eSpark-Backup/johnwollam-lcdproject/Software-Files/MessageApp/ODES/Resources/tbbg3.jpg

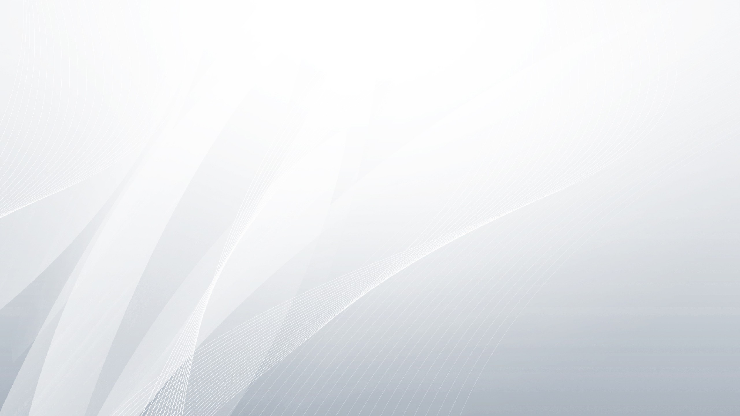
Software-Files/MessageApp/ODES/Resources/tbbg3.jpg
