eSpark-Backup/johnwollam-lcdproject/README.md

# JohnWollam-LCDProject
To develop an LCD based Security System for StorGuard
