eSpark-Backup/johnwollam-lcdproject/Design files/_Design_Files_New/John_Wollam.PcbDoc.htm

Reporting Options

# File in Previous Format

Date | : | 5/25/2022
Time | : | 8:13:49 PM
Filename | : | C:\GitHub\JohnWollam-LCDProject\Design files\_Design_Files_New\John_Wollam.PcbDoc

Version | Warning

This file was generated by an earlier version of the software
