eSpark-Backup/johnwollam-lcdproject/Deliverables/Renderings/2D_Bottom_View.PNG

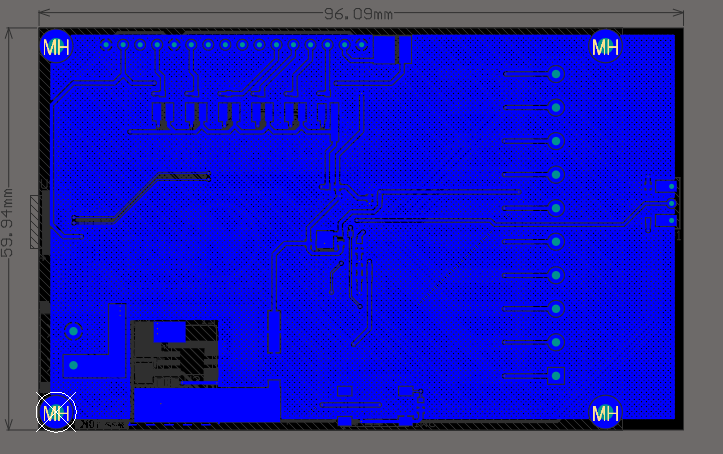
Deliverables/Renderings/2D_Bottom_View.PNG
