eSpark-Backup/johnwollam-lcdproject/Deliverables/Renderings/2D_Top.PNG

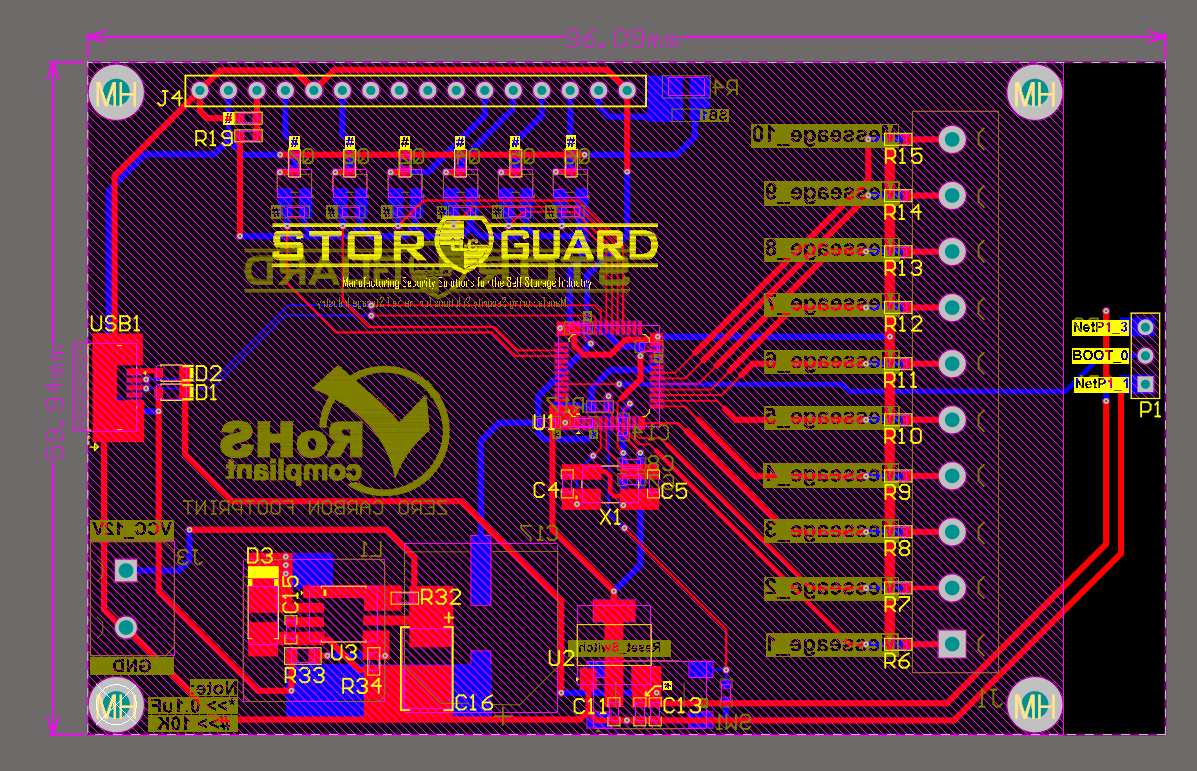
Deliverables/Renderings/2D_Top.PNG
