eSpark-Backup/johnwollam-lcdproject/Deliverables/Renderings/3D_Bottom.PNG.png

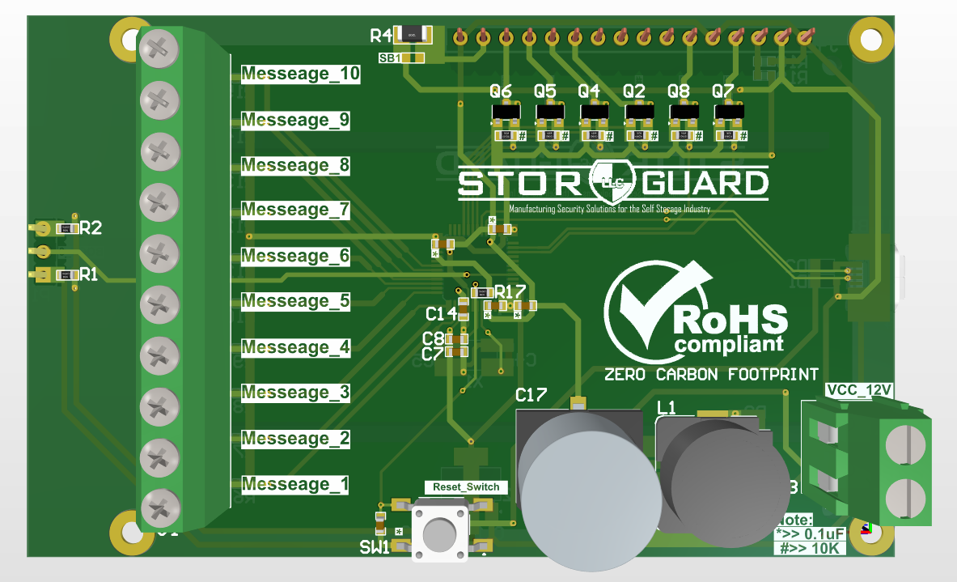
Deliverables/Renderings/3D_Bottom.PNG.png
