eSpark-Backup/johnwollam-lcdproject/Deliverables/Renderings/3D_Isometric.PNG

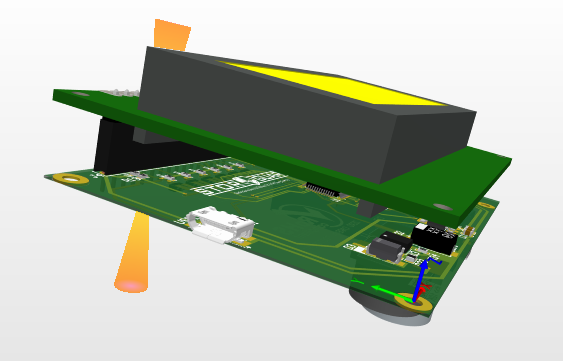
Deliverables/Renderings/3D_Isometric.PNG
