eSpark-Backup/johnwollam-lcdproject/Deliverables/Renderings/3D_Isometric_1.PNG

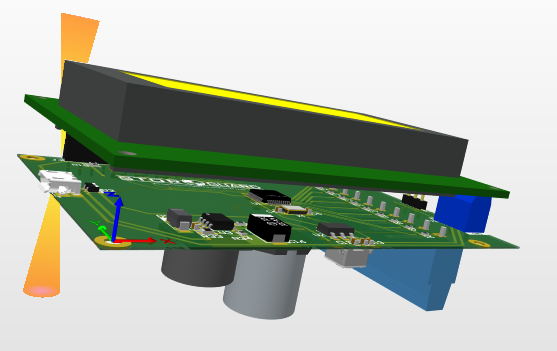
Deliverables/Renderings/3D_Isometric_1.PNG
