eSpark-Backup/johnwollam-lcdproject/Deliverables/Renderings/3D_Isometric_1.PNG.png

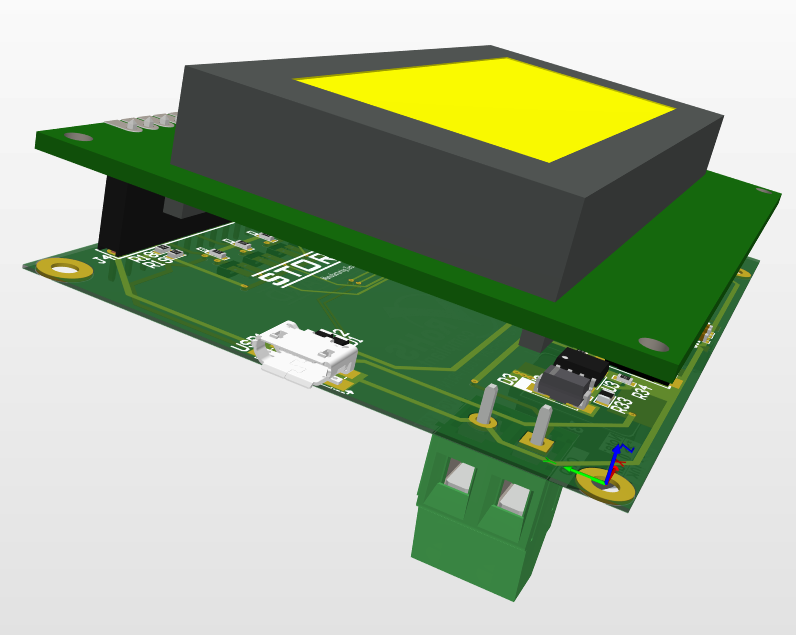
Deliverables/Renderings/3D_Isometric_1.PNG.png
