eSpark-Backup/johnwollam-lcdproject/Deliverables/Renderings/3D_Isometric_View.PNG

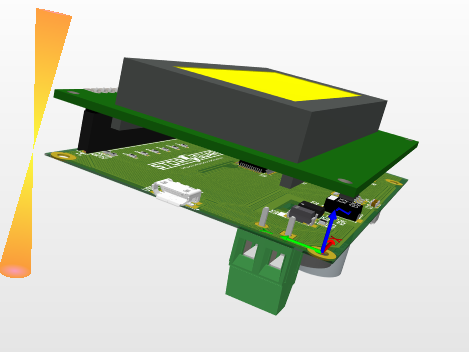
Deliverables/Renderings/3D_Isometric_View.PNG
