eSpark-Backup/johnwollam-lcdproject/Deliverables/Renderings/3D_Top.PNG.png

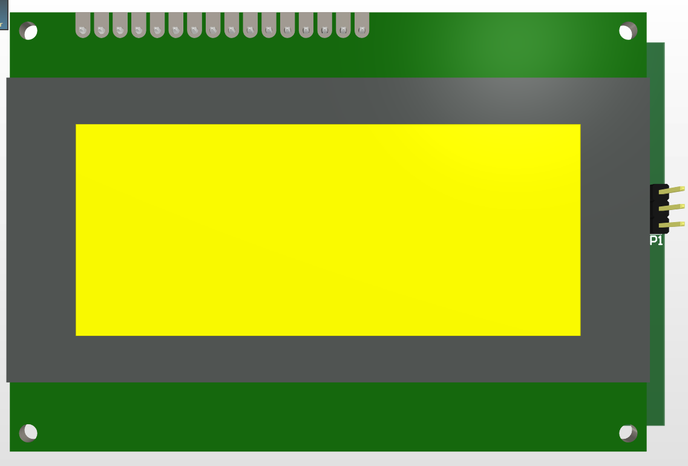
Deliverables/Renderings/3D_Top.PNG.png
