eSpark-Backup/johnwollam-lcdproject/Software-Files/MessageApp/ODES/Resources/bg2.jpg

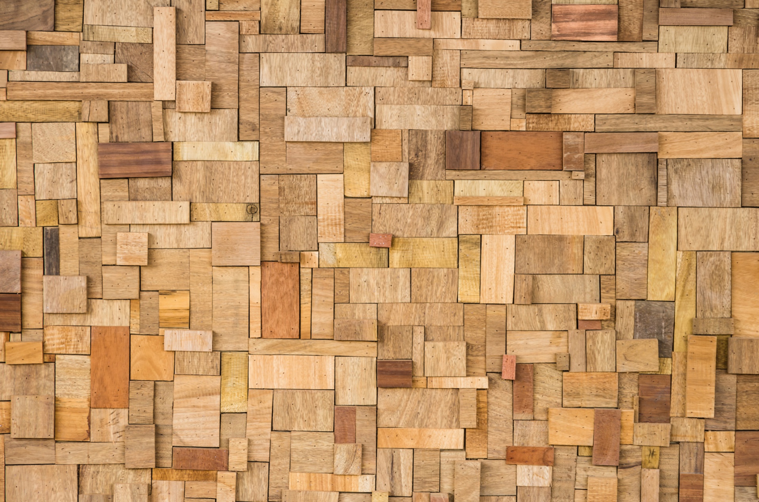
Software-Files/MessageApp/ODES/Resources/bg2.jpg
