eSpark-Backup/johnwollam-lcdproject/Software-Files/MessageApp/ODES/Resources/LoginScreen.png

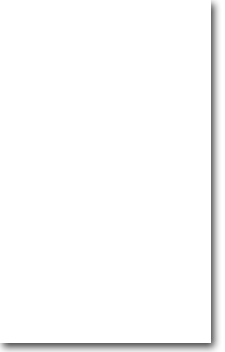
Software-Files/MessageApp/ODES/Resources/LoginScreen.png
