eSpark-Backup/johnwollam-lcdproject/Deliverables/BOM/Espark_BOM.xlsx

 |  | Component list |  | Bill of Materials for Project [John Wollam]
 |  | Source Data From: |  | John Wollam
 |  | Project: |  | John Wollam
 |  | Variant: |  | None
# | Item Type | Designator | Description | Footprint | Manufacturer Part Number | Manufacturer | Alternate Part Number | LCSC/Part Number | Value | Quantity | Quantity (10 Boards) | MOQ (10 Boards) | Quantity (25 Boards) | MOQ (25 Boards) | Links | Unit Cost (10 Boards) | Total Cost (10 Boards) | Unit Cost (25 Boards) | Total Cost (25 Boards) | Remarks | Reviewer Remarks
1 | Capacitor | C1, C2, C3, C6, C9, C10 | CAP CER 0.1UF 50V Y5V 0603 | Cap-0603 | CC0603ZRY5V9BB104 | Yageo | - | C106221 | 0.1uF | 6 | 60 | 100 | 150 | 200 | LCSC (https://lcsc.com/product-detail/Multilayer-Ceramic-Capacitors-MLCC-SMD-SMT_YAGEO-CC0603ZRY5V9BB104_C106221.html) | $0.0029 | $0.29 | $0.0029 | $0.58
2 | Capacitor | C4, C5 | CAP CER 20PF 50V C0G/NPO 0603 | Cap-0603 | CC0603JRNPO9BN200 | Yageo | - | C105621 | 20pF | 2 | 20 | 100 | 50 | 100 | LCSC (https://lcsc.com/product-detail/Multilayer-Ceramic-Capacitors-MLCC-SMD-SMT_YAGEO-CC0603JRNPO9BN200_C105621.html) | $0.0029 | $0.29 | $0.0029 | $0.29
3 | Capacitor | C7, C13 | CAP CER 1UF 50V X7R 0603 | Cap-0603 | UMK107AB7105KA-T | Taiyo Yuden | - | C105174 | 1uF | 2 | 20 | 40 | 50 | 60 | LCSC (https://lcsc.com/product-detail/Multilayer-Ceramic-Capacitors-MLCC-SMD-SMT_Taiyo-Yuden-UMK107AB7105KA-T_C105174.html) | $0.0294 | $1.18 | $0.0294 | $1.76
4 | Capacitor | C8 | CAP CER 10000PF 50V X7R 0603 | Cap0603 | CC0603KRX7R9BB103 | Yageo | - | C100042 | 10000pF | 1 | 10 | 100 | 25 | 100 | LCSC (https://lcsc.com/product-detail/Multilayer-Ceramic-Capacitors-MLCC-SMD-SMT_YAGEO-CC0603KRX7R9BB103_C100042.html) | $0.0022 | $0.22 | $0.0022 | $0.22
5 | Capacitor | C11, C14 | CAP CER 4.7UF 25V X5R 0603 | Cap-0603 | GRM188R61E475KE11D | Murata | - | C90057 | 4.7uF | 2 | 20 | 30 | 50 | 60 | LCSC (https://lcsc.com/product-detail/Multilayer-Ceramic-Capacitors-MLCC-SMD-SMT_Murata-Electronics-GRM188R61E475KE11D_C90057.html) | $0.0677 | $2.03 | $0.0677 | $4.06
6 | Capacitor | C15 | CAP CER 470pF 10% X7R 50V 0603 SMD | Cap-0603 | CC0603KRX7R9BB471 | Yageo | - | C107092 | 470pF | 1 | 10 | 100 | 25 | 100 | LCSC (https://lcsc.com/product-detail/Multilayer-Ceramic-Capacitors-MLCC-SMD-SMT_YAGEO-CC0603KRX7R9BB471_C107092.html) | $0.0026 | $0.26 | $0.0026 | $0.26
7 | Capacitor | C16 | CAP TANT 100UF 20% 25V 2917 | Case-E | TAJE107M025RNJ | Kyocera AVX | - | C7230 | 100uF | 1 | 10 | 12 | 25 | 28 | LCSC (https://lcsc.com/product-detail/Tantalum-Capacitors_Kyocera-AVX-TAJE107M025RNJ_C7230.html) | $1.0548 | $12.66 | $1.0548 | $29.53
8 | Capacitor | C17 | 470uF ±20% 50V 12.5mm 13.5mm 1000hrs 105℃ -40℃~+105℃ SMD,12.5x13.5mm Aluminum Electrolytic Capacitors - SMD RoHS | Custom | VT1H471MI135000CE0 | Changzhou Huawei Elec | - | C191227 | 470uF | 1 | 10 | 12 | 25 | 28 | LCSC (https://lcsc.com/product-detail/Aluminum-Electrolytic-Capacitors-SMD_Changzhou-Huawei-Elec-VT1H471MI135000CE0_C191227.html) | $0.3718 | $4.46 | $0.3453 | $9.67
9 | Diode | D1, D2 | DIODE GEN PURP 75V 150MA SOD323 | SOD-323 | 1N4148WS-7-F | Diodes | - | C60580 | - | 2 | 20 | 40 | 50 | 60 | LCSC (https://lcsc.com/product-detail/Switching-Diode_Diodes-Incorporated-1N4148WS-7-F_C60580.html) | $0.0258 | $1.03 | $0.0258 | $1.55
10 | Diode | D3 | 40V 500mV@2A 2A SMA(DO-214AC) Schottky Barrier Diodes (SBD) ROHS | SMA | SS24A | Guangdong Hottech | - | C2886579 | - | 1 | 10 | 20 | 25 | 40 | LCSC (https://www.lcsc.com/product-detail/Schottky-Barrier-Diodes-SBD_Guangdong-Hottech-SS24A_C2886579.html) | $0.0313 | $0.63 | $0.0313 | $1.25
11 | Terminal Block | J1 | TERM BLK 10P SIDE ENT 5.08MM PCB | Custom | ~~OSTTC102162~~ | On-Shore Technology | JL301-50010U02 | C409141 | - | 1 | 10 | 12 | 25 | 28 | LCSC (https://www.lcsc.com/product-detail/span-style-background-color-ff0-Screw-span-span-style-background-color-ff0-terminal-span_JILN-JL301-50010U02_C409141.html) | $0.3237 | $3.88 | $0.3237 | $9.06 |  | Design change needed
12 | Terminal Block | J3 | 2.5 18A Green Straight pin 5.08mm 1 14~30 2 Straight,P=5.08mm | Custom | WJ500V-5.08-2P | Ningbo Kangnex Elec | - | C8465 | - | 1 | 10 | 15 | 25 | 30 | LCSC (https://www.lcsc.com/product-detail/Screw-terminal_Ningbo-Kangnex-Elec-WJ500V-5-08-2P_C8465.html) | $0.1186 | $1.78 | $0.1186 | $3.56
13 | Header | J4 | CONN HDR 16POS 0.1 GOLD PCB | Custom | ~~PPPC161LFBN-RC~~ | Sullins | PM254-1-16-Z-8.5 | C2897379 | - | 1 | 10 | 12 | 25 | 30 | LCSC (https://www.lcsc.com/product-detail/Female-Headers_TXGA-FFH25405-S16S1001K6K_C2834190.html) | $0.2173 | $2.61 | $0.2173 | $6.52 |  | Alternate suggested due to low stock
14 | Inductor | L1 | Inductor Power Shielded Wirewound 220uH 20% 1KHz Ferrite 1.3A 310mOhm DCR Blister T/R | Custom | SLF12575T-221M1R3-PF | TDK | - | C93225 | 220uH | 1 | 10 | 12 | 25 | 28 | LCSC (https://www.lcsc.com/product-detail/Power-Inductors_TDK-SLF12575T-221M1R3-PF_C93225.html) | $0.3819 | $4.58 | $0.3819 | $10.69
15 | Connector | P1 | CONN HEADER VERT 3POS 2.54MM | Custom | ~~61300311121~~ | Wurth Electronics | PZ254V-11-03P | C2937625 | - | 1 | 10 | 50 | 25 | 50 | LCSC (https://www.lcsc.com/product-detail/Pin-Headers_XFCN-PZ254V-11-03P_C2937625.html) | $0.0151 | $0.76 | $0.0151 | $0.76
16 | Mosfet | Q2, Q4, Q5, Q6, Q7, Q8 | MOSFET N-CH 50V 200MA SOT-23 | SOT-23 | ~~BSS138LT1G~~ | ON Semiconductor | LBSS138LT1G | C8490 | - | 6 | 60 | 80 | 150 | 160 | LCSC (https://www.lcsc.com/product-detail/MOSFETs_LRC-LBSS138LT1G_C8490.html) | $0.0238 | $1.90 | $0.0238 | $3.81 | Alternate suggested due to low stock
17 | Resistor | R1, R2 | RES SMD 50K OHM 0.1% 0.15W 0603 | Res-0603 | ~~PNM0603E5002BST5~~ | Vishay Dale Thin Film | AR03BTC5002A | C304067 | 50K | 2 | 20 | 30 | 50 | 60 | LCSC (https://www.lcsc.com/product-detail/Chip-Resistor-Surface-Mount_Viking-Tech-AR03BTC5002A_C304067.html) | $0.0745 | $2.23 | $0.0745 | $4.47
18 | Resistor | R4 | RES SMD 3.6 OHM 1% 1/4W 1206 | Res-1206 | ~~CRCW12063R60FKEA~~ | Vishay Dale | RC1206JR-073R6L | C246070 | 3.6R | 1 | 10 | 50 | 25 | 50 | LCSC (https://www.lcsc.com/product-detail/Chip-Resistor-Surface-Mount_YAGEO-RC1206JR-073R6L_C246070.html) | $0.0153 | $0.77 | $0.0153 | $0.77
19 | Resistor | R6, R7, R8, R9, R10, R11, R12, R13, R14, R15, R17 | RES 20K OHM 1% 1/10W 0603 | Res-0603 | RC0603FR-0720KL | Yageo | - | C105575 | 20K | 11 | 110 | 200 | 275 | 300 | LCSC (https://www.lcsc.com/product-detail/Chip-Resistor-Surface-Mount_YAGEO-RC0603FR-0720KL_C105575.html) | $0.0014 | $0.28 | $0.0014 | $0.42
20 | Resistor | R18 | RES SMD 1K OHM 1% 1/10W 0603 | Res-0603 | RC0603FR-071KL | Yageo | - | C22548 | 1K | 1 | 10 | 100 | 25 | 100 | LCSC (https://www.lcsc.com/product-detail/Chip-Resistor-Surface-Mount_YAGEO-RC0603FR-071KL_C22548.html) | $0.0010 | $0.10 | $0.0010 | $0.10 | R18 Value changed BOM and Design also
21 | Resistor | R19 | DNP | Res-0603 | DNP | - | - | - | - | 1 | 10 | - | 25 | - | - | - | - | - | - | - | -
22 | Resistor | R20, R21, R22, R23, R24, R25, R26, R27, R28, R29, R30, R31 | RES SMD 10K Ohm 1% 1/10W 0603 | Res-0603 | RC0603FR-0710KL | Yageo | - | C98220 | 10K | 12 | 120 | 200 | 300 | 400 | LCSC (https://www.lcsc.com/product-detail/Chip-Resistor-Surface-Mount_YAGEO-RC0603FR-0710KL_C98220.html) | $0.0011 | $0.22 | $0.0011 | $0.44
23 | Resistor | R32 | ±1% 1/10W Thick Film Resistors 75V ±600ppm/℃ -55℃~+155℃ 0.33Ω 0603 Chip Resistor - Surface Mount ROHS | Res-0603 | RTT03R330FTP | RALEC | - | C103893 | 0.33R | 1 | 10 | 50 | 25 | 50 | LCSC (https://www.lcsc.com/product-detail/Chip-Resistor-Surface-Mount_RALEC-RTT03R330FTP_C103893.html) | $0.0041 | $0.21 | $0.0041 | $0.21
24 | Resistor | R33 | 100mW Thin Film Resistor 100V 3.75kΩ 0805 Chip Resistor | RES-0805 | AR05BTB3751A010 | Viking Tech | - | C374641 | 3.75K | 1 | 10 | 12 | 25 | 28 | LCSC (https://www.lcsc.com/product-detail/Chip-Resistor-Surface-Mount_Viking-Tech-AR05BTB3751A010_C374641.html) | $0.1498 | $1.80 | $0.1348 | $3.77
25 | Resistor | R34 | ±1% 1/10W Thick Film Resistors 75V ±100ppm/℃ -55℃~+155℃ 1.2kΩ 0603 Chip Resistor - Surface Mount ROHS | Res-0603 | 0603WAF1201T5E | UNI-ROYAL | - | C22765 | 1.2K | 1 | 10 | 100 | 25 | 100 | LCSC (https://www.lcsc.com/product-detail/Chip-Resistor-Surface-Mount_UNI-ROYAL-Uniroyal-Elec-0603WAF1201T5E_C22765.html) | $0.0010 | $0.10 | $0.0010 | $0.10
26 | ~~Solder Brigde~~ | ~~SB1~~ | ~~Solder Bridge ON~~ | ~~Custom~~ | ~~-~~ | ~~-~~ | ~~-~~ | ~~-~~ | ~~-~~ | ~~1~~ | ~~10~~ | ~~-~~ | ~~25~~ | ~~-~~ | ~~-~~ | ~~-~~ | ~~-~~ | ~~-~~ | ~~-~~ | ~~Do not mount~~
27 | SWITCH | SW1 | SWITCH TACTILE SPST-NO 0.05A 12V | Custom | TL3301NF160QG/TR | E-Switch | - | C273526 | - | 1 | 10 | 12 | 25 | 28 | LCSC (https://www.lcsc.com/product-detail/Tactile-Switches_E-Switch-TL3301NF160QG_C273526.html) | $0.4734 | $5.68 | $0.4287 | $12.00
28 | IC | U1 | IC MCU 32BIT 128KB FLASH 48LQFP | 48-LQFP (7x7)_ | STM32F070CBT6TR | STMicroelectronics | - | C2053863 | - | 1 | 10 | 12 | 25 | 27 | LCSC (https://www.lcsc.com/product-detail/Microcontroller-Units-MCUs-MPUs-SOCs_STMicroelectronics-STM32F070CBT6TR_C2053863.html) | $9.0369 | $108.44 | $9.0369 | $244.00
29 | IC | U2 | IC REG LINEAR 3.3V 1.2A SOT223 | SOT- 223 | LDL1117S33R | STMicroelectronics | - | C435835 | - | 1 | 10 | 12 | 25 | 27 | LCSC (https://www.lcsc.com/product-detail/Linear-Voltage-Regulators-LDO_STMicroelectronics-LDL1117S33R_C435835.html) | $0.5491 | $6.59 | $0.5491 | $14.83
30 | IC | U3 | IC REG BUCK BST ADJ 1.5A 8SOIC | SOIC-8 | MC34063ADR | Texas Instruments | - | C100023 | - | 1 | 10 | 12 | 25 | 27 | LCSC (https://www.lcsc.com/product-detail/DC-DC-Converters_Texas-Instruments-MC34063ADR_C100023.html) | $0.3237 | $3.88 | $0.3237 | $8.74
31 | Connector | USB1 | CONN RCPT USB2.0 MICRO B SMD R/A | Custom | 10118192-0001LF | Amphenol FCI | - | C132564 | - | 1 | 10 | 15 | 25 | 30 | LCSC (https://www.lcsc.com/product-detail/USB-Connectors_Amphenol-ICC-10118192-0001LF_C132564.html) | $0.2736 | $4.10 | $0.2736 | $8.21
32 | Crystal | X1 | CRYSTAL 8.0000MHZ 18PF SMD | Custom | ~~7B08070001~~ | TXC | 5TJ480000XYLBC | C2149247 | 8MHZ | 1 | 10 | 15 | 25 | 30 | LCSC (https://www.lcsc.com/product-detail/Crystals_JYJE-5TJ480000XYLBC_C2149247.html) | $0.2691 | $4.04 | $0.2691 | $8.07 | Design change needed
 |  |  |  |  |  |  |  |  |  |  |  |  |  |  | Total Cost |  | $177.00 |  | $389.70
 |  |  |  |  |  |  |  |  |  |  |  |  |  |  | Cost per Board |  | $17.70 |  | $15.59
