eSpark-Backup/johnwollam-lcdproject/Deliverables/BOM/PCBWay_BOM.xlsx

 |  | Component list |  | Bill of Materials for Project [John Wollam]
 |  | Source Data From: |  | John Wollam
 |  | Project: |  | John Wollam
 |  | Variant: |  | None
# | Item Type | Designator | Description | Footprint | Manufacturer Part Number | Manufacturer | LCSC/Part Number | Value | Quantity per Head | MOQ (25 Boards) | Remarks
1 | Capacitor | C1, C2, C3, C6, C9, C10 | CAP CER 0.1UF 50V Y5V 0603 | Cap-0603 | CC0603ZRY5V9BB104 | Yageo | C106221 | 0.1uF | 6 | 200
2 | Capacitor | C4, C5 | CAP CER 20PF 50V C0G/NPO 0603 | Cap-0603 | CC0603JRNPO9BN200 | Yageo | C105621 | 20pF | 2 | 100
3 | Capacitor | C7, C13 | CAP CER 1UF 50V X7R 0603 | Cap-0603 | UMK107AB7105KA-T | Taiyo Yuden | C105174 | 1uF | 2 | 60
4 | Capacitor | C8 | CAP CER 10000PF 50V X7R 0603 | Cap0603 | CC0603KRX7R9BB103 | Yageo | C100042 | 10000pF | 1 | 100
5 | Capacitor | C11, C14 | CAP CER 4.7UF 25V X5R 0603 | Cap-0603 | GRM188R61E475KE11D | Murata | C90057 | 4.7uF | 2 | 60
6 | Capacitor | C15 | CAP CER 470pF 10% X7R 50V 0603 SMD | Cap-0603 | CC0603KRX7R9BB471 | Yageo | C107092 | 470pF | 1 | 100
7 | Capacitor | C16 | CAP TANT 100UF 20% 25V 2917 | Case-E | TAJE107M025RNJ | Kyocera AVX | C7230 | 100uF | 1 | 28
8 | Capacitor | C17 | 470uF ±20% 50V 12.5mm 13.5mm 1000hrs 105℃ -40℃~+105℃ SMD,12.5x13.5mm Aluminum Electrolytic Capacitors - SMD RoHS | Custom | VT1H471MI135000CE0 | Changzhou Huawei Elec | C191227 | 470uF | 1 | 28
9 | Diode | D1, D2 | DIODE GEN PURP 75V 150MA SOD323 | SOD-323 | 1N4148WS-7-F | Diodes | C60580 | - | 2 | 60
10 | Diode | D3 | 40V 500mV@2A 2A SMA(DO-214AC) Schottky Barrier Diodes (SBD) ROHS | SMA | SS24A | Guangdong Hottech | C2886579 | - | 1 | 40
11 | Terminal Block | J1 | TERM BLK 10P SIDE ENT 5.08MM PCB | Custom | JL301-50010U02 | On-Shore Technology | C409141 | - | 1 | 28
12 | Terminal Block | J3 | 2.5 18A Green Straight pin 5.08mm 1 14~30 2 Straight,P=5.08mm | Custom | WJ500V-5.08-2P | Ningbo Kangnex Elec | C8465 | - | 1 | 30
13 | Header | J4 | CONN HDR 16POS 0.1 GOLD PCB | Custom | PM254-1-16-Z-8.5 | Sullins | C2897379 | - | 1 | 30
14 | Inductor | L1 | Inductor Power Shielded Wirewound 220uH 20% 1KHz Ferrite 1.3A 310mOhm DCR Blister T/R | Custom | SLF12575T-221M1R3-PF | TDK | C93225 | 220uH | 1 | 28
15 | Connector | P1 | CONN HEADER VERT 3POS 2.54MM | Custom | PZ254V-11-03P | Wurth Electronics | C2937625 | - | 1 | 50
16 | Mosfet | Q2, Q4, Q5, Q6, Q7, Q8 | MOSFET N-CH 50V 200MA SOT-23 | SOT-23 | LBSS138LT1G | ON Semiconductor | C8490 | - | 6 | 160
17 | Resistor | R1, R2 | RES SMD 50K OHM 0.1% 0.15W 0603 | Res-0603 | AR03BTC5002A | Vishay Dale Thin Film | C304067 | 50K | 2 | 60
18 | Resistor | R4 | RES SMD 3.6 OHM 1% 1/4W 1206 | Res-1206 | RC1206JR-073R6L | Vishay Dale | C246070 | 3.6R | 1 | 50
19 | Resistor | R6, R7, R8, R9, R10, R11, R12, R13, R14, R15, R17 | RES 20K OHM 1% 1/10W 0603 | Res-0603 | RC0603FR-0720KL | Yageo | C105575 | 20K | 11 | 300
20 | Resistor | R18 | RES SMD 1K OHM 1% 1/10W 0603 | Res-0603 | RC0603FR-071KL | Yageo | C22548 | 1K | 1 | 100
21 | Resistor | R19 | DNP | Res-0603 | DNP | - | - | - | 1 | -
22 | Resistor | R20, R21, R22, R23, R24, R25, R26, R27, R28, R29, R30, R31 | RES SMD 10K Ohm 1% 1/10W 0603 | Res-0603 | RC0603FR-0710KL | Yageo | C98220 | 10K | 12 | 400
23 | Resistor | R32 | ±1% 1/10W Thick Film Resistors 75V ±600ppm/℃ -55℃~+155℃ 0.33Ω 0603 Chip Resistor - Surface Mount ROHS | Res-0603 | RTT03R330FTP | RALEC | C103893 | 0.33R | 1 | 50
24 | Resistor | R33 | 100mW Thin Film Resistor 100V 3.75kΩ 0805 Chip Resistor | RES-0805 | AR05BTB3751A010 | Viking Tech | C374641 | 3.75K | 1 | 28
25 | Resistor | R34 | ±1% 1/10W Thick Film Resistors 75V ±100ppm/℃ -55℃~+155℃ 1.2kΩ 0603 Chip Resistor - Surface Mount ROHS | Res-0603 | 0603WAF1201T5E | UNI-ROYAL | C22765 | 1.2K | 1 | 100
26 | ~~Solder Brigde~~ | ~~SB1~~ | ~~Solder Bridge ON~~ | ~~Custom~~ | ~~-~~ | ~~-~~ | ~~-~~ | ~~-~~ | ~~1~~ | ~~-~~
27 | SWITCH | SW1 | SWITCH TACTILE SPST-NO 0.05A 12V | Custom | TL3301NF160QG/TR | E-Switch | C273526 | - | 1 | 28
28 | IC | U1 | IC MCU 32BIT 128KB FLASH 48LQFP | 48-LQFP (7x7)_ | STM32F070CBT6TR | STMicroelectronics | C2053863 | - | 1 | 27
29 | IC | U2 | IC REG LINEAR 3.3V 1.2A SOT223 | SOT- 223 | LDL1117S33R | STMicroelectronics | C435835 | - | 1 | 27
30 | IC | U3 | IC REG BUCK BST ADJ 1.5A 8SOIC | SOIC-8 | MC34063ADR | Texas Instruments | C100023 | - | 1 | 27
31 | Connector | USB1 | CONN RCPT USB2.0 MICRO B SMD R/A | Custom | 10118192-0001LF | Amphenol FCI | C132564 | - | 1 | 30
32 | Crystal | X1 | CRYSTAL 8.0000MHZ 18PF SMD | Custom | ~~7B08070001~~ | TXC | C2149247 | 8MHZ | 1 | 30
 |  | Approved
 |  | Notes
