eSpark-Backup/johnwollam-lcdproject/Deliverables/BOM/Bill of Materials-John Wollam.xlsx

 | Component list |  | Bill of Materials for Project [John Wollam.PrjPCB] (No PCB Document Selected)
 | Source Data From: |  | John Wollam.PrjPCB
 | Project: |  | John Wollam.PrjPCB
 | Variant: |  | None
# | Designator | Description | Footprint | Manufacturer Part Number | Alternate Part No | Manufacturer | LCSC/Part No | Comment | Quantity | Quantity/10 Board | LCSC/MOQ | Link | Unit Price/10 | Total Price/10 | Remarks | Reviewer Remarks
1 | C1, C2, C3, C6, C9, C10 | CAP CER 0.1UF 50V Y5V 0603 | Cap0603 | CC0603ZRY5V9BB104 | --------- | Yageo | C106221 | 0.1uF | 6 | 60 | 100 | LCSC (https://www.lcsc.com/product-detail/Multilayer-Ceramic-Capacitors-MLCC-SMD-SMT_YAGEO-CC0603ZRY5V9BB104_C106221.html) | $0.0033 | $0.33
2 | C4, C5 | CAP CER 20PF 50V C0G/NPO 0603 | Cap0603 | CC0603JRNPO9BN200 | --------- | Yageo | C105621 | 20pF | 2 | 20 | 100 | LCSC (https://www.lcsc.com/product-detail/Multilayer-Ceramic-Capacitors-MLCC-SMD-SMT_YAGEO-CC0603JRNPO9BN200_C105621.html) | $0.0038 | $0.38
3 | C7, C13 | CAP CER 1UF 50V X7R 0603 | Cap0603 | UMK107AB7105KA-T | --------- | Taiyo Yuden | C105174 | 1uF | 2 | 20 | 30 | LCSC (https://www.lcsc.com/product-detail/Multilayer-Ceramic-Capacitors-MLCC-SMD-SMT_Taiyo-Yuden-UMK107AB7105KA-T_C105174.html) | $0.0395 | $1.19
4 | C8 | CAP CER 10000PF 50V X7R 0603 | Cap0603 | CC0603KRX7R9BB103 | --------- | Yageo | C100042 | 10000pF | 1 | 10 | 100 | LCSC (https://www.lcsc.com/product-detail/Multilayer-Ceramic-Capacitors-MLCC-SMD-SMT_YAGEO-CC0603KRX7R9BB103_C100042.html) | $0.0026 | $0.26
5 | C11, C14 | CAP CER 4.7UF 25V X5R 0603 | Cap0603 | GRM188R61E475KE11D | --------- | Murata | C90057 | 4.7uF | 2 | 20 | 30 | LCSC (https://www.lcsc.com/product-detail/Multilayer-Ceramic-Capacitors-MLCC-SMD-SMT_Murata-Electronics-GRM188R61E475KE11D_C90057.html) | $0.0827 | $2.48
6 | C12 | CAP CER 470pF 10% X7R 50V 0603 SMD | Cap0603 | CC0603KRX7R9BB471 | --------- | Yageo | C107092 | 470pF | 1 | 10 | 100 | LCSC (https://www.lcsc.com/product-detail/Multilayer-Ceramic-Capacitors-MLCC-SMD-SMT_YAGEO-CC0603KRX7R9BB471_C107092.html) | $0.0034 | $0.34
7 | C36 | CAP TANT 100UF 20% 25V 2917 | CAP- 2917 | TAJE107M025RNJ | --------- | Kyocera AVX | C7230 | 100uF | 1 | 10 | 12 | LCSC (https://www.lcsc.com/product-detail/Tantalum-Capacitors_AVX-TAJE107M025RNJ_C7230.html) | $1.1614 | $13.94
8 | C37 | 470uF 7.7mm 10V 6.3mm ±20% SMD,6.3x7.7mm Aluminum Electrolytic Capacitors - SMD ROHS | Custom | RVT1A471M0607 | --------- | ROQANG | C335982 | 470uF | 1 | 10 | 12 | LCSC (https://lcsc.com/product-detail/Aluminum-Electrolytic-Capacitors-SMD_ROQANG-RVT1A471M0607_C335982.html) | $0.0459 | $0.55
9 | D1 | 40V 500mV@2A 2A SMA(DO-214AC) Schottky Barrier Diodes (SBD) ROHS | SMA | SS24A | --------- | Yangzhou | C2886579 | ---------- | 1 | 10 | 20 | LCSC (https://www.lcsc.com/product-detail/Schottky-Barrier-Diodes-SBD_Guangdong-Hottech-SS24A_C2886579.html) | $0.0317 | $0.63
10 | J1 | TERM BLK 12P SIDE ENT 5.08MM PCB | Custom | ~~OSTTA124163~~ | DB128V-5.0-12P-GN-S | On-Shore Technology | C424688 | ---------- | 1 | 10 | 11 | LCSC (https://www.lcsc.com/product-detail/span-style-background-color-ff0-Screw-span-span-style-background-color-ff0-terminal-span_DIBO-DB128V-5-0-12P-GN-S_C424688.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) | $0.6420 | $7.06
11 | J4 | CONN HDR 16POS 0.1 GOLD PCB | Custom | ~~PPPC161LFBN-RC~~ | 2685Y-116CNG1SNA01 | Sullins | C350305 | ---------- | 1 | 10 | 15 | LCSC (https://www.lcsc.com/product-detail/span-style-background-color-ff0-Female-span-Headers_HOAUC-2685Y-116CNG1SNA01_C350305.html) | $0.1250 | $1.88
12 | J5 | 10 Pin JTAG Header for ICE programmer (1.27mm Pitch) | Custom | B-2101S10P-B110 | --------- | Ckmtw | C2895038 | ---------- | 1 | 10 | 15 | LCSC (https://www.lcsc.com/product-detail/Pin-Headers_Ckmtw-Shenzhen-Cankemeng-B-2101S10P-B110_C2895038.html) | $0.0835 | $1.25
13 | J6 | CABLE ADAPTER 6 POS | Custom | TC2030-IDC | --------- | Tag-Connect | --------- | --------- | 1 | 10 | --------- | --------- | --------- | ---------
14 | L1 | Fixed Ind 22020%UH 0.834 Ohm 770M | Custom | SWPA6045S221MT | --------- | Sunlord | C91047 | 220uH | 1 | 10 | 15 | LCSC (https://www.lcsc.com/product-detail/Power-Inductors_Sunlord-SWPA6045S221MT_C91047.html) | $0.1799 | $2.70
15 | P1 | CONN HEADER VERT 3POS 2.54MM | HDR1X3 | ~~61300311121~~ | MTP125-1103S1 | Wurth Electronics | C358685 | ----------- | 1 | 10 | 50 | LCSC (https://www.lcsc.com/product-detail/span-style-background-color-ff0-Pin-span-Headers_MINTRON-MTP125-1103S1_C358685.html) | $0.0184 | $0.92
16 | Q2, Q3, Q4, Q5, Q6, Q7 | MOSFET N-CH 50V 200MA SOT-23 | SOT23-3 | BSS138LT1G | --------- | ON Semiconductor | C82045 | ----------- | 6 | 60 | 70 | LCSC (https://www.lcsc.com/product-detail/MOSFETs_onsemi-BSS138LT1G_C82045.html) | $0.2025 | $14.18
17 | R1, R2 | RES SMD 50K OHM 0.1% 0.15W 0603 | Res0603 | ~~PNM0603E5002BST5~~ | AR03BTC5002A | Vishay Dale Thin Film | C304067 | 50K | 2 | 20 | 25 | LCSC (https://www.lcsc.com/product-detail/Chip-span-style-background-color-ff0-Resistor-span-Surface-Mount_Viking-Tech-AR03BTC5002A_C304067.html) | $0.1135 | $2.84
18 | R4 | RES SMD 3.6 OHM 1% 1/4W 1206 | Res1206 | ~~CRCW12063R60FKEA~~ | 1206W4F360KT5E | Vishay Dale | C17998 | 3.6R | 1 | 10 | 50 | LCSC (https://www.lcsc.com/product-detail/Chip-span-style-background-color-ff0-Resistor-span-Surface-Mount_UNI-ROYAL-Uniroyal-Elec-1206W4F360KT5E_C17998.html) | $0.0065 | $0.33
19 | R6, R7, R8, R9, R10, R11, R12, R13, R14, R15, R17 | RES SMD 20K OHM 1% 1/10W 0603 | Res0603 | RC0603FR-0720KL | --------- | Yageo | C105575 | 20K | 11 | 110 | 200 | LCSC (https://www.lcsc.com/product-detail/Chip-Resistor-Surface-Mount_YAGEO-RC0603FR-0720KL_C105575.html) | $0.0016 | $0.32
20 | R18, R20, R21, R22, R23, R24, R25, R26, R27, R28, R29, R30, R31 | RES SMD 10K OHM 1% 1/10W 0603 | Res0603 | RC0603FR-0710KL | --------- | Yageo | C98220 | 10K | 13 | 130 | 200 | LCSC (https://www.lcsc.com/product-detail/Chip-Resistor-Surface-Mount_YAGEO-RC0603FR-0710KL_C98220.html) | $0.0014 | $0.28
21 | R19 | RES SMD 56K OHM 1% 1/10W 0603 | Res0603 | RC0603FR-0756KL | --------- | Yageo | C114630 | 56K | 1 | 10 | 100 | LCSC (https://www.lcsc.com/product-detail/Chip-Resistor-Surface-Mount_YAGEO-RC0603FR-0756KL_C114630.html) | $0.0016 | $0.16
22 | R35 | ±1% 1/10W Thick Film Resistors 75V ±600ppm/℃ -55℃~+155℃ 0.33Ω 0603 Chip Resistor - Surface Mount ROHS | Res0603 | RTT03R330FTP | --------- | RALEC | C103893 | 0.33R | 1 | 10 | 50 | LCSC (https://www.lcsc.com/product-detail/Chip-Resistor-Surface-Mount_RALEC-RTT03R330FTP_C103893.html) | $0.0043 | $0.21
23 | R36 | Res Thick Film 0402 3.6K Ohm 5% 1/16W ±100ppm/°C Molded SMD SMD Paper T/R | Res0402 | RC0402JR-073K6L | --------- | Yageo | C137873 | 3.6K | 1 | 10 | 100 | LCSC (https://www.lcsc.com/product-detail/Chip-Resistor-Surface-Mount_YAGEO-RC0402JR-073K6L_C137873.html) | $0.0036 | $0.36
24 | R40 | ±1% 1/10W Thick Film Resistors 75V ±100ppm/℃ -55℃~+155℃ 1.2kΩ 0603 Chip Resistor - Surface Mount ROHS | Res0603 | 0603WAF1201T5E | --------- | UNI-ROYAL | C22765 | 1.2K | 1 | 10 | 100 | LCSC (https://www.lcsc.com/product-detail/Chip-Resistor-Surface-Mount_UNI-ROYAL-Uniroyal-Elec-0603WAF1201T5E_C22765.html) | $0.0014 | $0.14
25 | SB1 | Solder Bridge ON | Custom | --------- | --------- | --------- | --------- | --------- | 1 | 10 | --------- | --------- | --------- | ---------
26 | SW1 | Switch Tactile N.O. SPST Round Button Gull Wing 0.05A 12VDC 100000Cycles 1.57N SMD T/R | Custom | TL3301NF160QG | --------- | E-Switch | C273526 | --------- | 1 | 10 | 12 | LCSC (https://www.lcsc.com/product-detail/Tactile-Switches_E-Switch-TL3301NF160QG_C273526.html) | $0.4509 | $5.41
27 | U1 | IC MCU 32BIT 32KB FLASH 48LQFP | LQFP-48 | STM32F070C6T6 | --------- | STMicroelectronics | --------- | --------- | 1 | 10 | 11 | ALiexpress (https://www.aliexpress.com/item/1005004166471600.html) | $6.5000 | $71.50 |  |  | 3.16
28 | U2 | 1.5-A boost, buck, inverting switching regulator, operation from 0°C to 70°C 8-SOIC 0 to 70 | SOIC-8 | MC34063ADR | --------- | Texas Instruments | C100023 | --------- | 1 | 10 | 11 | LCSC (https://www.lcsc.com/product-detail/DC-DC-Converters_Texas-Instruments-MC34063ADR_C100023.html) | $0.3968 | $4.36
29 | U3 | IC REG LINEAR 3.3V 1.2A SOT223 | SOT-223-4 | LDL1117S33R | --------- | STMicroelectronics | C435835 | --------- | 1 | 10 | 11 | LCSC (https://www.lcsc.com/product-detail/Linear-Voltage-Regulators-LDO_STMicroelectronics-LDL1117S33R_C435835.html) | $0.8458 | $9.30
30 | USB1 | CONN USB MICRO B RECPT SMT R/A | Custom | 10118192-0001LF | --------- | Amphenol FCI | C132564 | --------- | 1 | 10 | 11 | LCSC (https://www.lcsc.com/product-detail/USB-Connectors_Amphenol-ICC-10118192-0001LF_C132564.html) | $0.2336 | $2.57
31 | X1 | CRYSTAL 8.0000MHZ 18PF SMD | Custom | ~~7B08070001~~ | 5TJ480000XYLBC | TXC | --------- | 8MHZ | 1 | 10 | 11 | LCSC (https://lcsc.com/product-detail/Crystals_JYJE-5TJ480000XYLBC_C2149247.html) | $0.2264 | $2.49
 | Approved |  |  |  |  |  |  |  |  |  | Total Component Cost |  |  | $148.36
 | Notes |  |  |  |  |  |  |  |  |  | Single Board Cost |  |  | $14.84
 |  |  |  |  |  |  |  |  |  |  | Aliexpress Shipping Cost |  |  | $3.16
 |  |  |  |  |  |  |  |  |  |  | Total Cost Single Board |  |  | $18.00
