eSpark-Backup/johnwollam-lcdproject/Deliverables/Espark,John Wollam.xlsx

 |  | Component list |  | Bill of Materials for Project [John Wollam.PrjPCB]
 |  | Source Data From: |  | John Wollam.PrjPCB
 |  | Project: |  | John Wollam.PrjPCB
 |  | Variant: |  | None
# | Item Type | Designator | Description | Footprint | Manufacturer Part Number | Manufacturer | Alternate Part Number | LCSC/Part Number | Comment | Quantity | Quantity (10 Boards) | MOQ (10 Boards) | Quantity (25 Boards) | MOQ (25 Boards) | Links | Unit Cost (10 Boards) | Total Cost (10 Boards) | Unit Cost (25 Boards) | Total Cost (25 Boards) | Remarks | Column=Reviewer Remarks
1 | Capacitor | C1, C2, C3, C6, C9, C10 | CAP CER 0.1UF 50V Y5V 0603 | Cap-0603 | CC0603ZRY5V9BB104 | Yageo |  |  | 0.1uF | 6 | 60 | 100 | 150 | 200 | LCSC (https://lcsc.com/product-detail/Multilayer-Ceramic-Capacitors-MLCC-SMD-SMT_YAGEO-CC0603ZRY5V9BB104_C106221.html) | 0.0029 |  | 0.0029
2 | Capacitor | C4, C5 | CAP CER 20PF 50V C0G/NPO 0603 | Cap-0603 | CC0603JRNPO9BN200 | Yageo |  |  | 20pF | 2 | 20 | 100 | 50 | 100 | LCSC (https://lcsc.com/product-detail/Multilayer-Ceramic-Capacitors-MLCC-SMD-SMT_YAGEO-CC0603JRNPO9BN200_C105621.html) | 0.0029 |  | 0.0029
3 | Capacitor | C7, C13 | CAP CER 1UF 50V X7R 0603 | Cap-0603 | UMK107AB7105KA-T | Taiyo Yuden |  |  | 1uF | 2 | 20 | 40 | 50 | 60 | LCSC (https://lcsc.com/product-detail/Multilayer-Ceramic-Capacitors-MLCC-SMD-SMT_Murata-Electronics-UMK107AB7105KA-T_C5125798.html) | 0.0395 |  | 0.0395
4 | Capacitor | C8 | CAP CER 10000PF 50V X7R 0603 | Cap0603 | CC0603KRX7R9BB103 | Yageo |  |  | 10000pF | 1 | 10 | 100 | 25 | 100 | LCSC (https://lcsc.com/product-detail/Multilayer-Ceramic-Capacitors-MLCC-SMD-SMT_YAGEO-CC0603KRX7R9BB103_C100042.html) | 0.0022 |  | 0.0022
5 | Capacitor | C11, C14 | CAP CER 4.7UF 25V X5R 0603 | Cap-0603 | GRM188R61E475KE11D | Murata |  |  | 4.7uF | 2 | 20 | 30 | 50 | 60 | LCSC (https://lcsc.com/product-detail/Multilayer-Ceramic-Capacitors-MLCC-SMD-SMT_Murata-Electronics-GRM188R61E475KE11D_C90057.html) | 0.0677 |  | 0.0677
6 | Capacitor | C15 | CAP CER 470pF 10% X7R 50V 0603 SMD | Cap-0603 | CC0603KRX7R9BB471 | Yageo |  |  | 470pF | 1 | 10 | 100 | 25 | 100 | LCSC (https://lcsc.com/product-detail/Multilayer-Ceramic-Capacitors-MLCC-SMD-SMT_YAGEO-CC0603KRX7R9BB471_C107092.html) | 0.0026 |  | 0.0026
7 | Capacitor | C16 | CAP TANT 100UF 20% 25V 2917 | Case-E | TAJE107M025RNJ | Kyocera AVX |  |  | 100uF | 1 | 10 | 15 | 25 | 30 | LCSC (https://lcsc.com/product-detail/Tantalum-Capacitors_Kyocera-AVX-TAJE107M025RNJ_C7230.html) | 0.8125 |  | 0.7884
8 | Capacitor | C17 | 470uF ±20% 50V 12.5mm 13.5mm 1000hrs 105℃ -40℃~+105℃ SMD,12.5x13.5mm Aluminum Electrolytic Capacitors - SMD RoHS | Custom | VT1H471MI135000CE0 | Changzhou Huawei Elec |  |  | 470uF | 1 | 10 | 15 | 25 | 30 | LCSC (https://lcsc.com/product-detail/Aluminum-Electrolytic-Capacitors-SMD_Changzhou-Huawei-Elec-VT1H471MI135000CE0_C191227.html) | 0.3718 |  | 0.3391
9 | Diode | D1, D2 | DIODE GEN PURP 75V 150MA SOD323 | SOD-323 | 1N4148WS-7-F | Diodes |  |  | 1N4148WS-7-F | 2 | 20 | 40 | 50 | 60 | LCSC (https://lcsc.com/product-detail/Switching-Diode_Diodes-Incorporated-1N4148WS-7-F_C60580.html) | 0.0258 |  | 0.0258
10 | Diode | D3 | 40V 500mV@2A 2A SMA(DO-214AC) Schottky Barrier Diodes (SBD) ROHS | SMA | SS24A | Guangdong Hottech |  |  | SS24A | 1 | 10 | 20 | 25 | 40 | LCSC (https://www.lcsc.com/product-detail/Schottky-Barrier-Diodes-SBD_Guangdong-Hottech-SS24A_C2886579.html) | 0.0313 |  | 0.0313
11 | Header | J1 | TERM BLK 10P SIDE ENT 5.08MM PCB | Custom | OSTTC102162 | On-Shore Technology |  |  | OSTTC102162 | 1 | 10 | 13 | 25 | 28 | Custum Supplier (https://www.verical.com/pd/on-shore-technology--inc-terminal-blocks-OSTTC102162-5048237) | 1.0241 |  | 0.981
12 | Header | J3 | 2.5 18A Green Straight pin 5.08mm 1 14~30 2 Straight,P=5.08mm | Custom | WJ500V-5.08-2P | Ningbo Kangnex Elec |  |  | WJ500V-5.08-2P | 1 | 10 | 15 | 25 | 30 | LCSC (https://www.lcsc.com/product-detail/Screw-terminal_Ningbo-Kangnex-Elec-WJ500V-5-08-2P_C8465.html) | 0.1186 |  | 0.1186
13 | Header | J4 | CONN HDR 16POS 0.1 GOLD PCB | Custom | PPPC161LFBN-RC | Sullins |  |  | 16 Pin Female Header With LCD Step | 1 | 10 |  | 25
14 | Inductor | L1 | Inductor Power Shielded Wirewound 220uH 20% 1KHz Ferrite 1.3A 310mOhm DCR Blister T/R | Custom | SLF12575T-221M1R3-PF | TDK |  |  | 220uH | 1 | 10 | 15 | 25 | 30 | LCSC (https://www.lcsc.com/product-detail/Power-Inductors_TDK-SLF12575T-221M1R3-PF_C93225.html) | 0.3701 |  | 0.3305
15 | Connector | P1 | CONN HEADER VERT 3POS 2.54MM | Custom | 61300311121 | Wurth Electronics |  |  | 61300311121 | 1 | 10 |  | 25
16 | Mosfet | Q2, Q4, Q5, Q6, Q7, Q8 | MOSFET N-CH 50V 200MA SOT-23 | SOT-23 | BSS138LT1G | ON Semiconductor |  |  | BSS138LT1G | 6 | 60 |  | 150 |  |  |  |  |  |  | LESS STOCK
17 | Resistor | R1, R2 | RES SMD 50K OHM 0.1% 0.15W 0603 | Res-0603 | ~~PNM0603E5002BST5~~ | Vishay Dale Thin Film | ARG05DTC5002 | C2828840 | 50K | 2 | 20 | 50 | 50 | 100 | LCSC (https://www.lcsc.com/product-detail/Chip-Resistor-Surface-Mount_Viking-Tech-ARG05DTC5002_C2828840.html) | 0.0126 |  | 0.0126 |  | WATTAGE RATTING IS DIFFEERENT
18 | Resistor | R4 | RES SMD 3.6 OHM 1% 1/4W 1206 | Res-1206 | ~~CRCW12063R60FKEA~~ | Vishay Dale | RC1206JR-073R6L | C246070 | 3.6R | 1 | 10 | 50 | 25 | 50 | LCSC (https://www.lcsc.com/product-detail/Chip-Resistor-Surface-Mount_YAGEO-RC1206JR-073R6L_C246070.html) | 0.0146 |  | 0.0146
19 | Resistor | R6, R7, R8, R9, R10, R11, R12, R13, R14, R15, R17 | RES 20K OHM 1% 1/10W 0603 | Res-0603 | RC0603FR-0720KL | Yageo |  |  | 20K | 11 | 110 | 100 | 275 | 100 | LCSC (https://www.lcsc.com/product-detail/Chip-Resistor-Surface-Mount_YAGEO-RC0603FR-0720KL_C105575.html) | 0.0014 |  | 0.0014
20 | Resistor | R18, R20, R21, R22, R23, R24, R25, R26, R27, R28, R29, R30, R31 | RES SMD 10K Ohm 1% 1/10W 0603 | Res-0603 | RC0603FR-0710KL | Yageo |  |  | 10K | 13 | 130 | 200 | 325 | 400 | LCSC (https://www.lcsc.com/product-detail/Chip-Resistor-Surface-Mount_YAGEO-RC0603FR-0710KL_C98220.html) | 0.0011 |  | 0.0011
21 | Resistor | R19 | RES 56K OHM 1% 1/10W 0603 | Res-0603 | RC0603FR-0756KL | Yageo |  |  | 56K | 1 | 10 | 100 | 25 | 100 | LCSC (https://www.lcsc.com/product-detail/Chip-Resistor-Surface-Mount_YAGEO-RC0603FR-0756KL_C114630.html) | 0.0013 |  | 0.0013
22 | Resistor | R32 | ±1% 1/10W Thick Film Resistors 75V ±600ppm/℃ -55℃~+155℃ 0.33Ω 0603 Chip Resistor - Surface Mount ROHS | Res-0603 | RTT03R330FTP | RALEC |  |  | 0.33R | 1 | 10 | 50 | 25 | 50 | LCSC (https://www.lcsc.com/product-detail/Chip-Resistor-Surface-Mount_RALEC-RTT03R330FTP_C103893.html) | 0.0041 |  | 0.0041
23 | Resistor | R33 | 100mW Thin Film Resistor 100V 3.75kΩ 0805 Chip Resistor | RES-0805 | AR05BTB3751A010 | Viking Tech |  |  | 3.75K | 1 | 10 | 15 | 25 | 30 | LCSC (https://www.lcsc.com/product-detail/Chip-Resistor-Surface-Mount_Viking-Tech-AR05BTB3751A010_C374641.html) | 0.1498 |  | 0.1348
24 | Resistor | R34 | ±1% 1/10W Thick Film Resistors 75V ±100ppm/℃ -55℃~+155℃ 1.2kΩ 0603 Chip Resistor - Surface Mount ROHS | Res-0603 | 0603WAF1201T5E | UNI-ROYAL |  |  | 1.2K | 1 | 10 | 100 | 25 | 100 | LCSC (https://www.lcsc.com/product-detail/Chip-Resistor-Surface-Mount_UNI-ROYAL-Uniroyal-Elec-0603WAF1201T5E_C22765.html) | 0.001 |  | 0.001
25 | Resistor | SB1 | Solder Bridge ON | Custom |  |  |  |  | Solder Bridge | 1 | 10 |  | 25
26 | SWITCH | SW1 | SWITCH TACTILE SPST-NO 0.05A 12V | Custom | TL3301NF160QG/TR | E-Switch |  |  | Tactile Switch | 1 | 10 |  | 25
27 | IC | U1 | IC MCU 32BIT 128KB FLASH 48LQFP | 48-LQFP (7x7)_ | STM32F070CBT6TR | STMicroelectronics |  |  | STM32F070CBT6TR | 1 | 10 | 13 | 25 | 28 | LCSC (https://www.lcsc.com/product-detail/Microcontroller-Units-MCUs-MPUs-SOCs_STMicroelectronics-STM32F070CBT6TR_C2053863.html) | 9.0369 |  | 9.0369
28 | IC | U2 | IC REG LINEAR 3.3V 1.2A SOT223 | SOT- 223 | LDL1117S33R | STMicroelectronics |  |  | LDL1117S33R | 1 | 10 | 13 | 25 | 28 | LCSC (https://www.lcsc.com/product-detail/Linear-Voltage-Regulators-LDO_STMicroelectronics-LDL1117S33R_C435835.html) | 0.5491 |  | 0.5491
29 | IC | U3 | IC REG BUCK BST ADJ 1.5A 8SOIC | SOIC-8 | MC34063ADR | Texas Instruments |  |  | MC34063ADR | 1 | 10 | 13 | 25 | 28 | LCSC (https://www.lcsc.com/product-detail/DC-DC-Converters_Texas-Instruments-MC34063ADR_C100023.html) | 0.3237 |  | 0.3237
30 | Connector | USB1 | CONN RCPT USB2.0 MICRO B SMD R/A | Custom | 10118192-0001LF | Amphenol FCI |  |  | 10118192-0001LF | 1 | 10 | 13 | 25 | 28 | LCSC (https://www.lcsc.com/product-detail/USB-Connectors_Amphenol-ICC-10118192-0001LF_C132564.html) | 0.2319 |  | 0.2319
31 | Crystal | X1 | CRYSTAL 8.0000MHZ 18PF SMD | Custom | 7B08070001 | TXC |  |  | 8MHZ | 1 | 10 |  | 25
