eSpark-Backup/johnwollam-lcdproject/Deliverables/Supporting Files/John_Wollam_V2.0.step

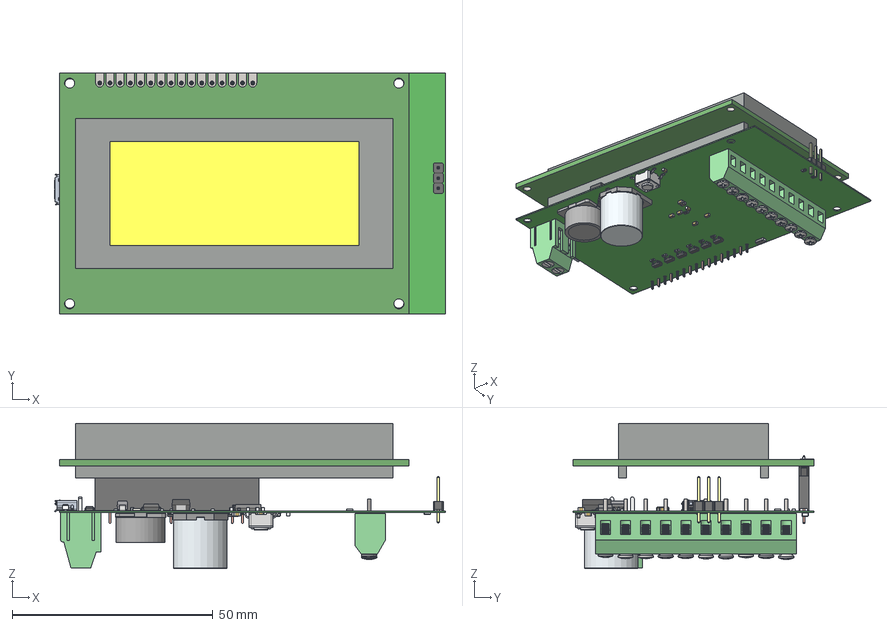
[picture p16: CAD file, 2023-01-05]
Deliverables/Supporting Files/John_Wollam_V2.0.step
97.4 x 60.0 x 36.2 mm
1912111437_JILN-JL301-50010U02_C409141-Real
oval_head_am_B18.6.7M_-_M2_x_0.4_x_8_Type_I_Cross_Recessed_OHMS_--8S x 10
User_Library-RESC1608X05N x 29
User_Library-CRYSTALSMD5X32
10118192C
User_Library-SOIC-8-1
User_Library-SOT-223-1
User_Library-P-LQFP48-7x7-0_50
TL1105CONTACTDOME
TL3301GBODY
TL1105COVER
TL3301ACTUATOR_N_4_3
User_Library-CR2012-0805
User_Library-1206_SMD_Resistor
CircuitWorks-SOT-23 x 6
User_Library-Header_Male_3Pin_PinArray
User_Library-Header_Male_3Pin_BodyArray
slf12575_RGB6710886 x 5
CFAH1604A-YYH-JTDISPLAYMODUL
PINHEADER16X1PITCH254
USER_LIBRARY-HEADER_FEMALE_1X16
WURTH_691216510002
User_Library-DO-214AC_SMA
User_Library-SOD323-1 x 2
Base
Pin1Fillet
Pin2Fillet
593D_D-CASE
User_Library-CAPC1608X09 x 14
