eSpark-Backup/johnwollam-lcdproject/Design files/_Design_Files_New/John_Wollam.step

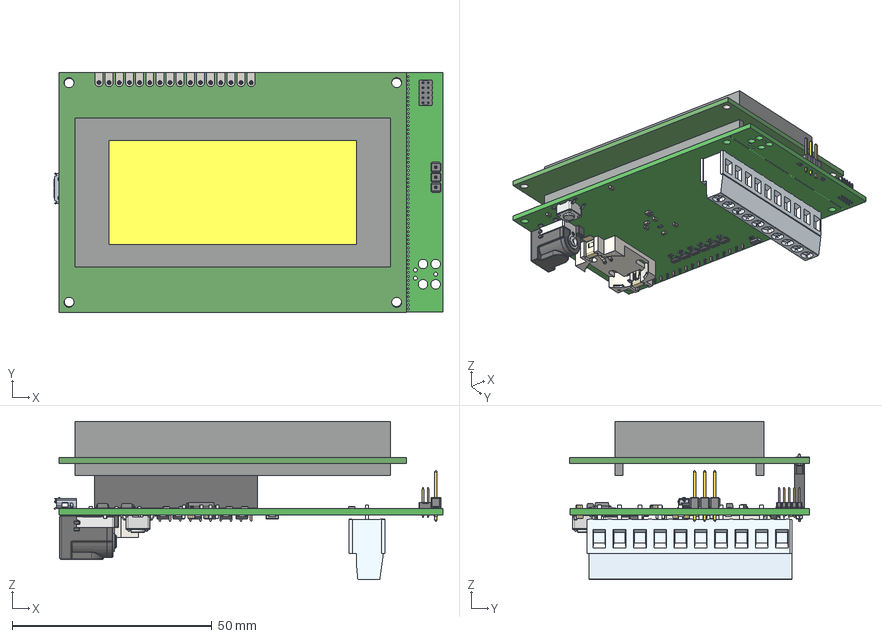
[picture p17: CAD file, 2022-03-03]
Design files/_Design_Files_New/John_Wollam.step
97.4 x 60.0 x 39.6 mm
Board
keystone-PN1060TR
CUI-PJ-002A-SMT
User_Library-Crystal
10118192C
User_Library-RESC1608X05N x 30
User_Library-1206_SMD_Resistor
CircuitWorks-SOT-23 x 8
622xxx21121_Pin x 10
622x1021121_Housing
User_Library-1x3_TH_Pitch_2_54mm x 18
User_Library-SOD123F x 2
TL1105CONTACTDOME
TL3301GBODY
TL1105COVER
TL3301ACTUATOR_N_4_3
CFAH1604A-YYH-JTDISPLAYMODUL
PINHEADER16X1PITCH254
USER_LIBRARY-HEADER_FEMALE_1X16
User_Library-CAPC1608X09 x 13
SW3dPS-SOT-223-1
User_Library-TQFP-48_pins_TQFP_pin_TQFP_022x07_1 x 48
User_Library-TQFP-48_body_10x1_TQFP_7x7_1
c-1-282841-0-h4-3d
