eSpark-Backup/johnwollam-lcdproject/Deliverables/Supporting Files/John_Wollam.step

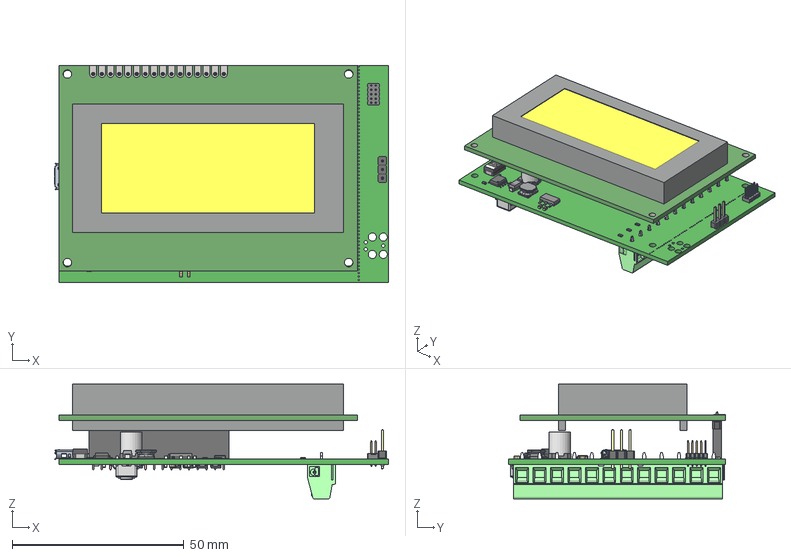
[picture p18: CAD file, 2022-06-09, an earlier design]
Deliverables/Supporting Files/John_Wollam.step
97.4 x 63.3 x 33.5 mm
U2-K_NCH
User_Library-SOIC-8-1
User_Library-RESC1608X05N x 30
User_Library-RES_1005-0402
User_Library-1206_SMD_Resistor
User_Library-DO-214AC_SMA
593D_D-CASE
User_Library-CAPC1608X09 x 14
SW3dPS-SOT-223-1
CircuitWorks-SOT-23 x 6
User_Library-Crystal
10118192C
622xxx21121_Pin x 10
622x1021121_Housing
User_Library-Header_Male_3Pin_PinArray
User_Library-Header_Male_3Pin_BodyArray
TL1105CONTACTDOME
TL3301GBODY
TL1105COVER
TL3301ACTUATOR_N_4_3
CFAH1604A-YYH-JTDISPLAYMODUL
PINHEADER16X1PITCH254
USER_LIBRARY-HEADER_FEMALE_1X16
User_Library-TQFP-48_pins_TQFP_pin_TQFP_022x07_1 x 48
User_Library-TQFP-48_body_10x1_TQFP_7x7_1
