eSpark-Backup/johnwollam-lcdproject/(list of files, cad)

Other CAD files:
Deliverables/Supporting Files/John_Wollam.DWG
Deliverables/Supporting Files/John_Wollam.DXF
Deliverables/Supporting Files/John_Wollam_V2.0.DWG
Deliverables/Supporting Files/John_Wollam_V2.0.DXF
