eSpark-Backup/johnwollam-lcdproject/Deliverables/Schematics/John Wollam.pdf

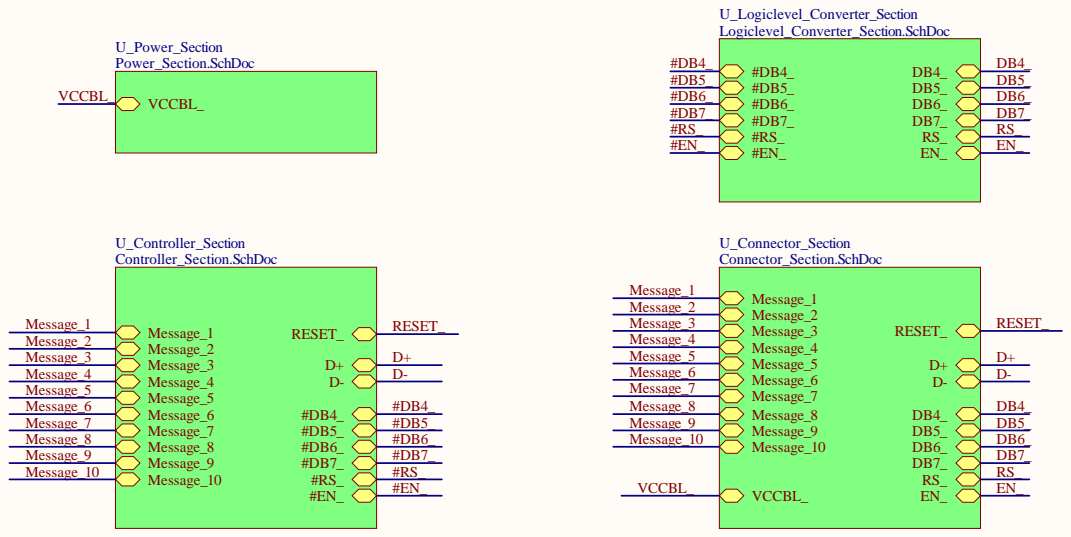
[picture p19: page 1]

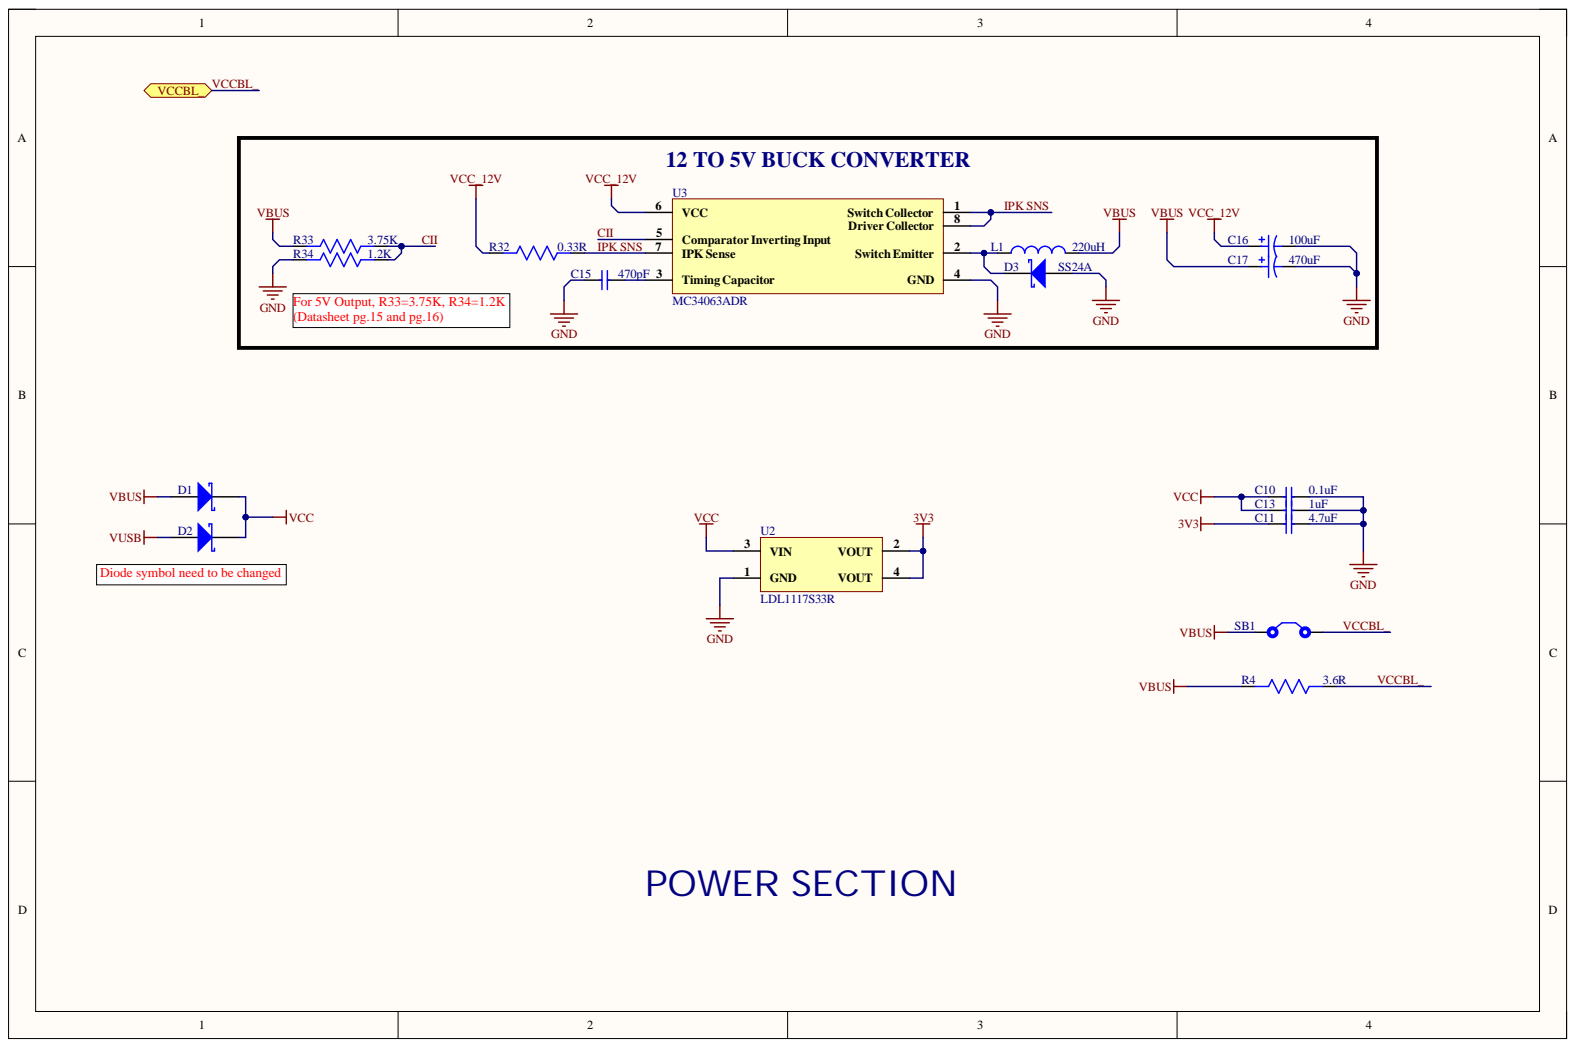
[picture p20: page 2]

For 5V Output, R33=3.75K, R34=1.2K
(Datasheet pg.15 and pg.16)

Diode symbol need to be changed

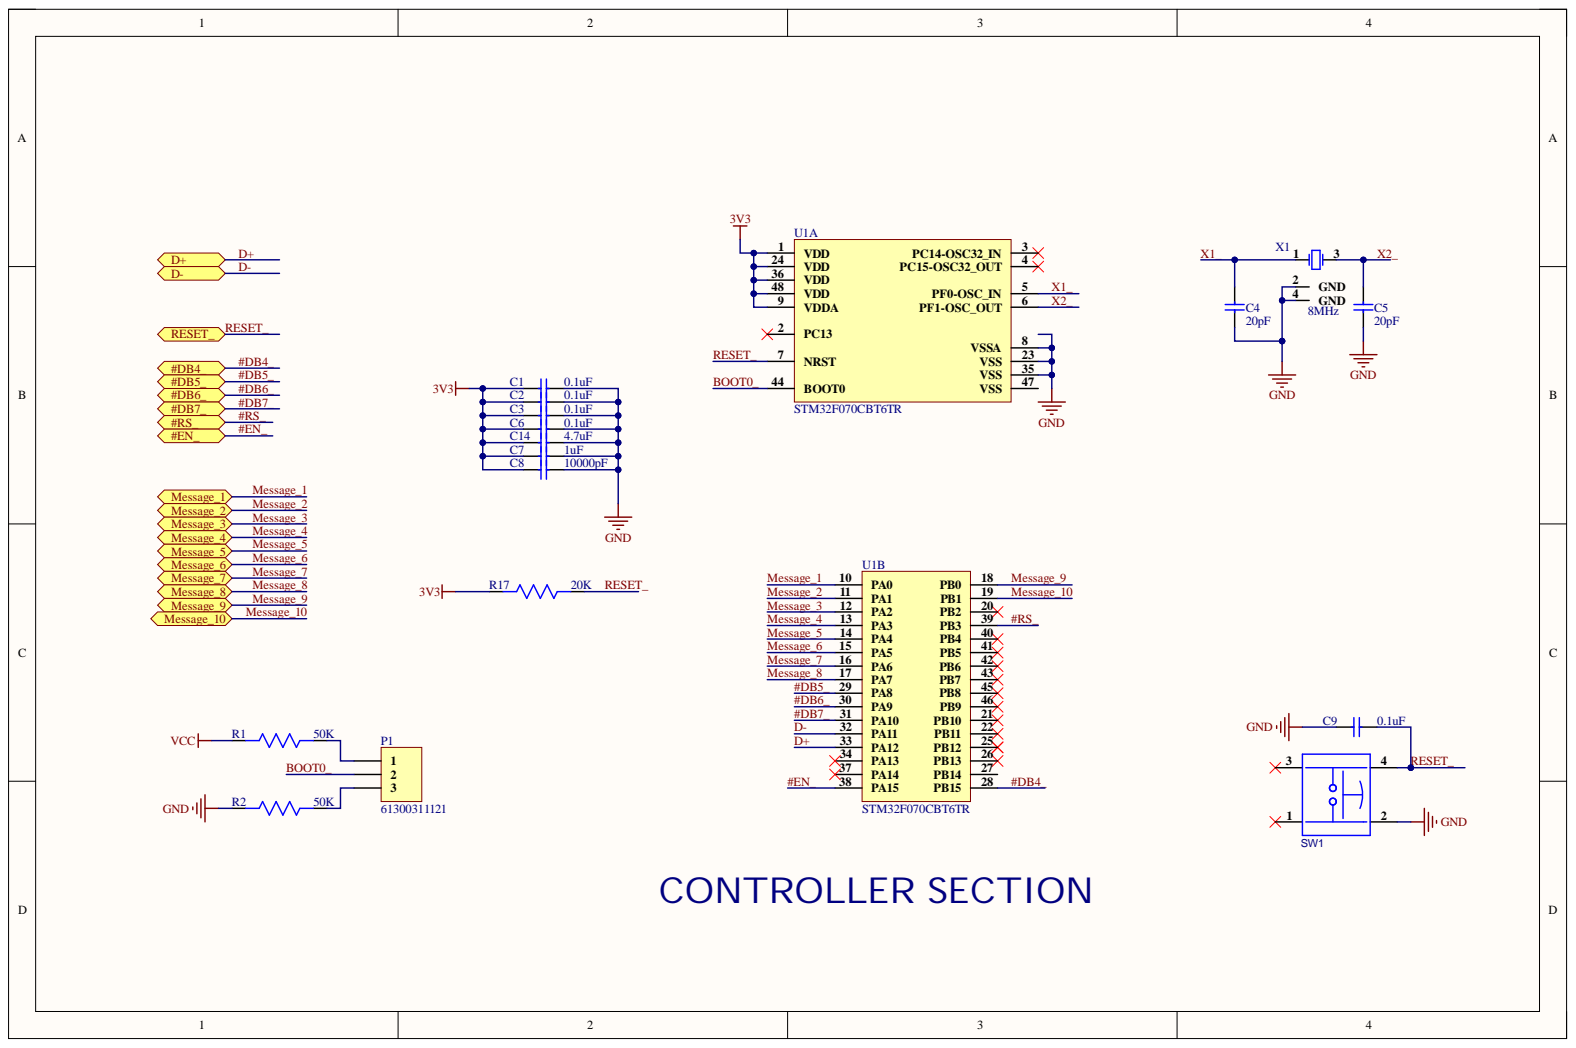
[picture p21: page 3]

C 2 | 0.1u F
C 3 | 0.1u F | U1 B
C 6 | 0.1u F
C14 | | 4.7u F
C 7 | | 1uF
C 8 | | 10000p F

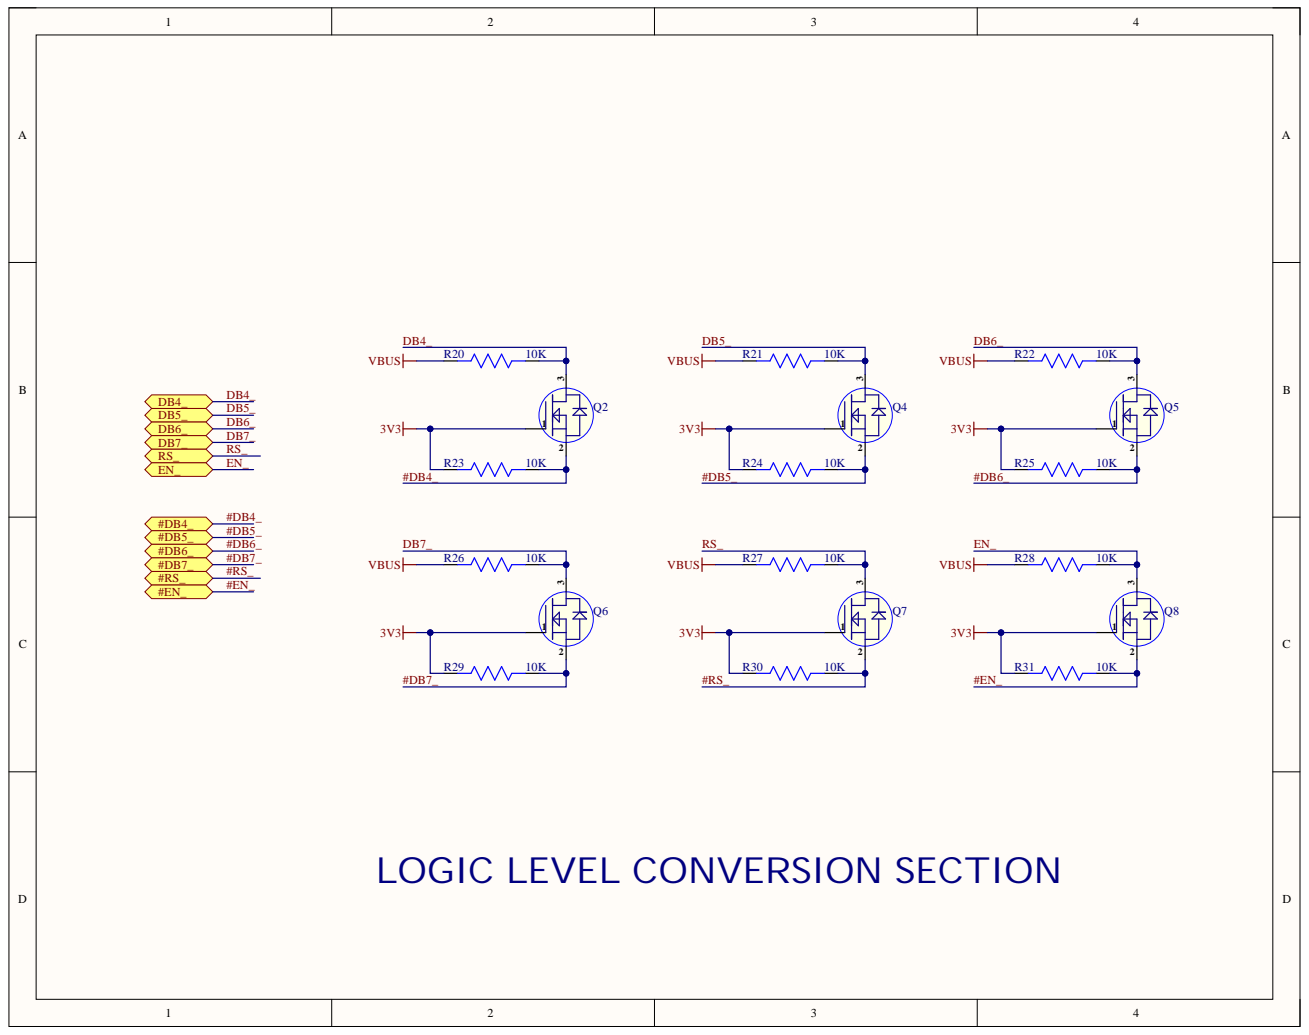
[picture p22: page 4]

LOGIC LEVEL CONVERSION SECTION

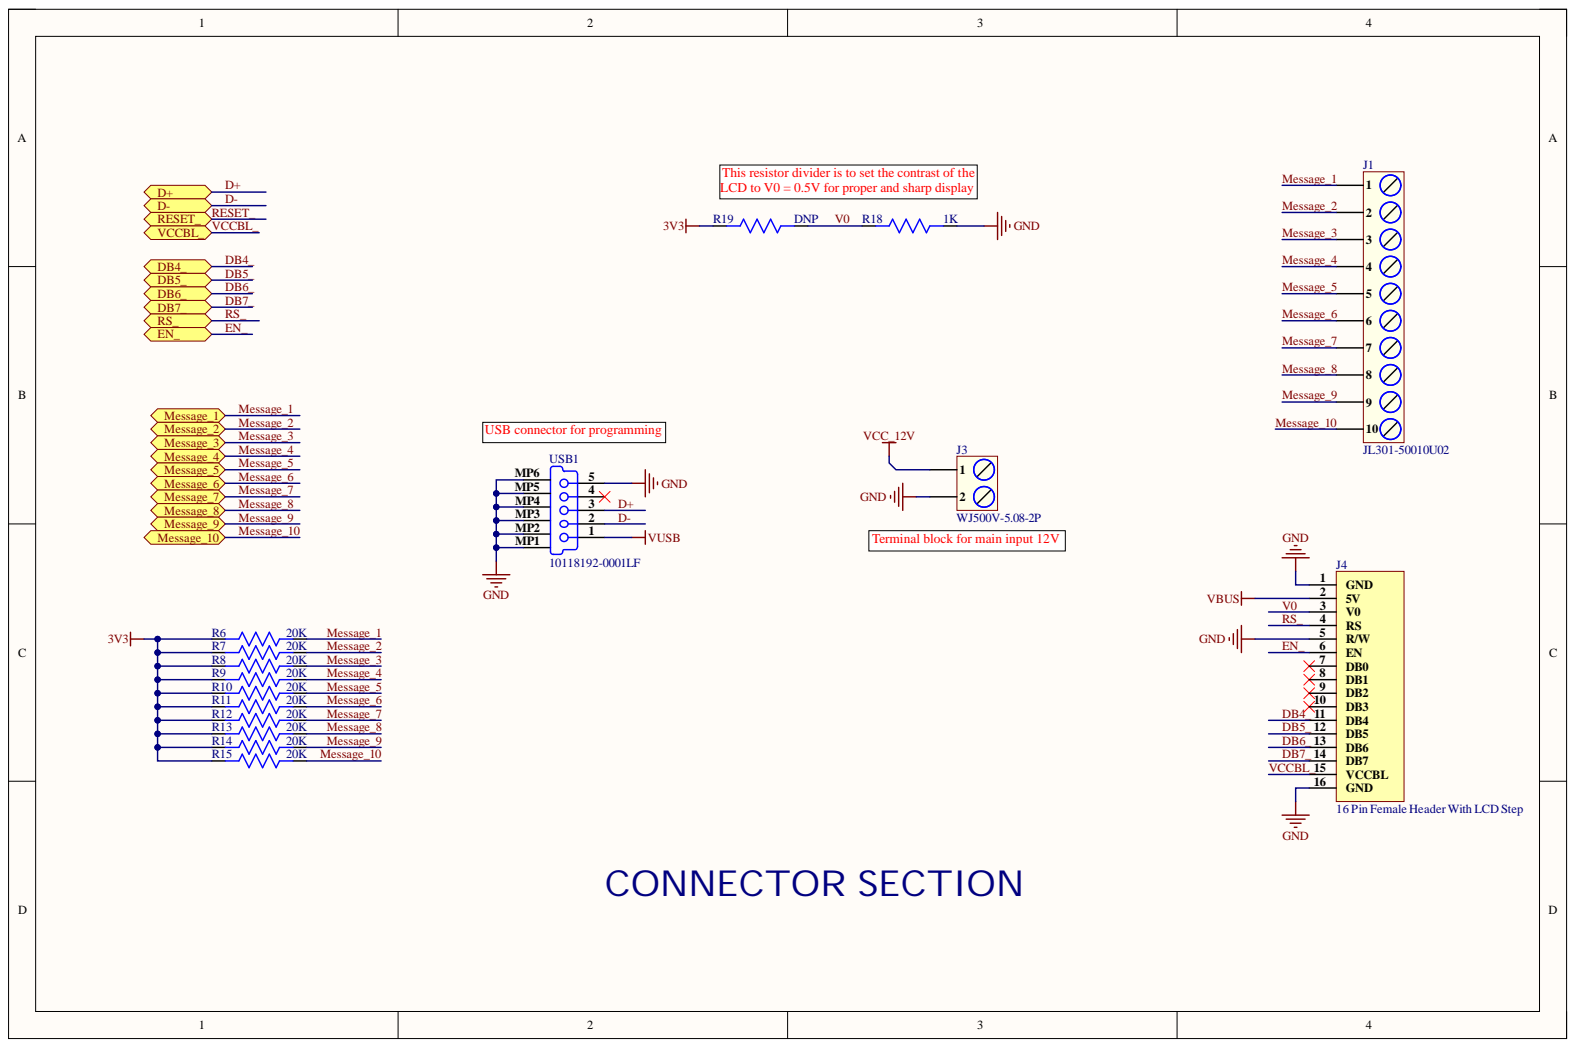
[picture p23: page 5]

This r
LCD to V0 = 0.5V for prope

r is to set the contr

rminal block for main input 12V
