eSpark-Backup/johnwollam-lcdproject/Design files/John Wollam.pdf

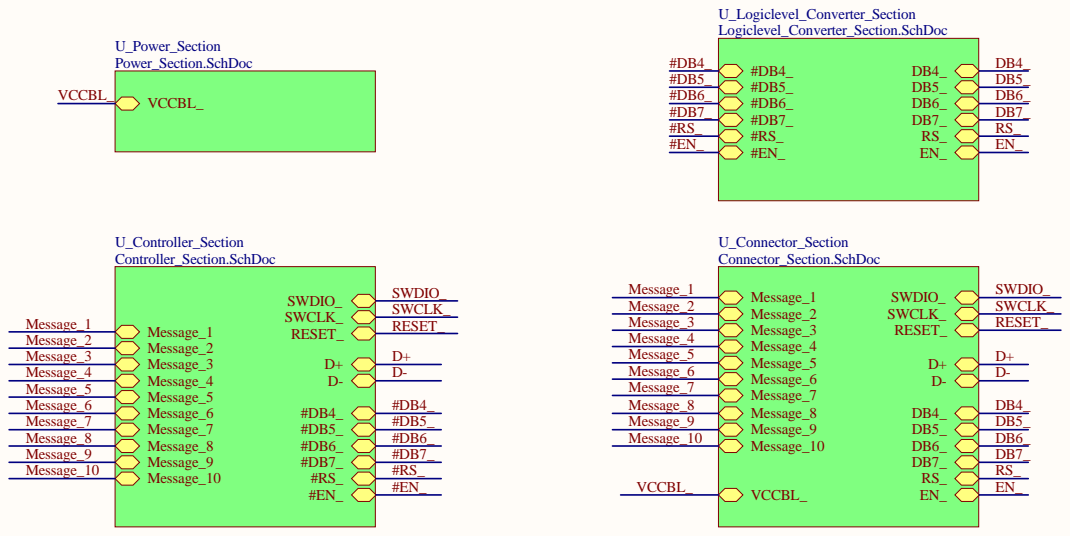
[picture p24: page 1]

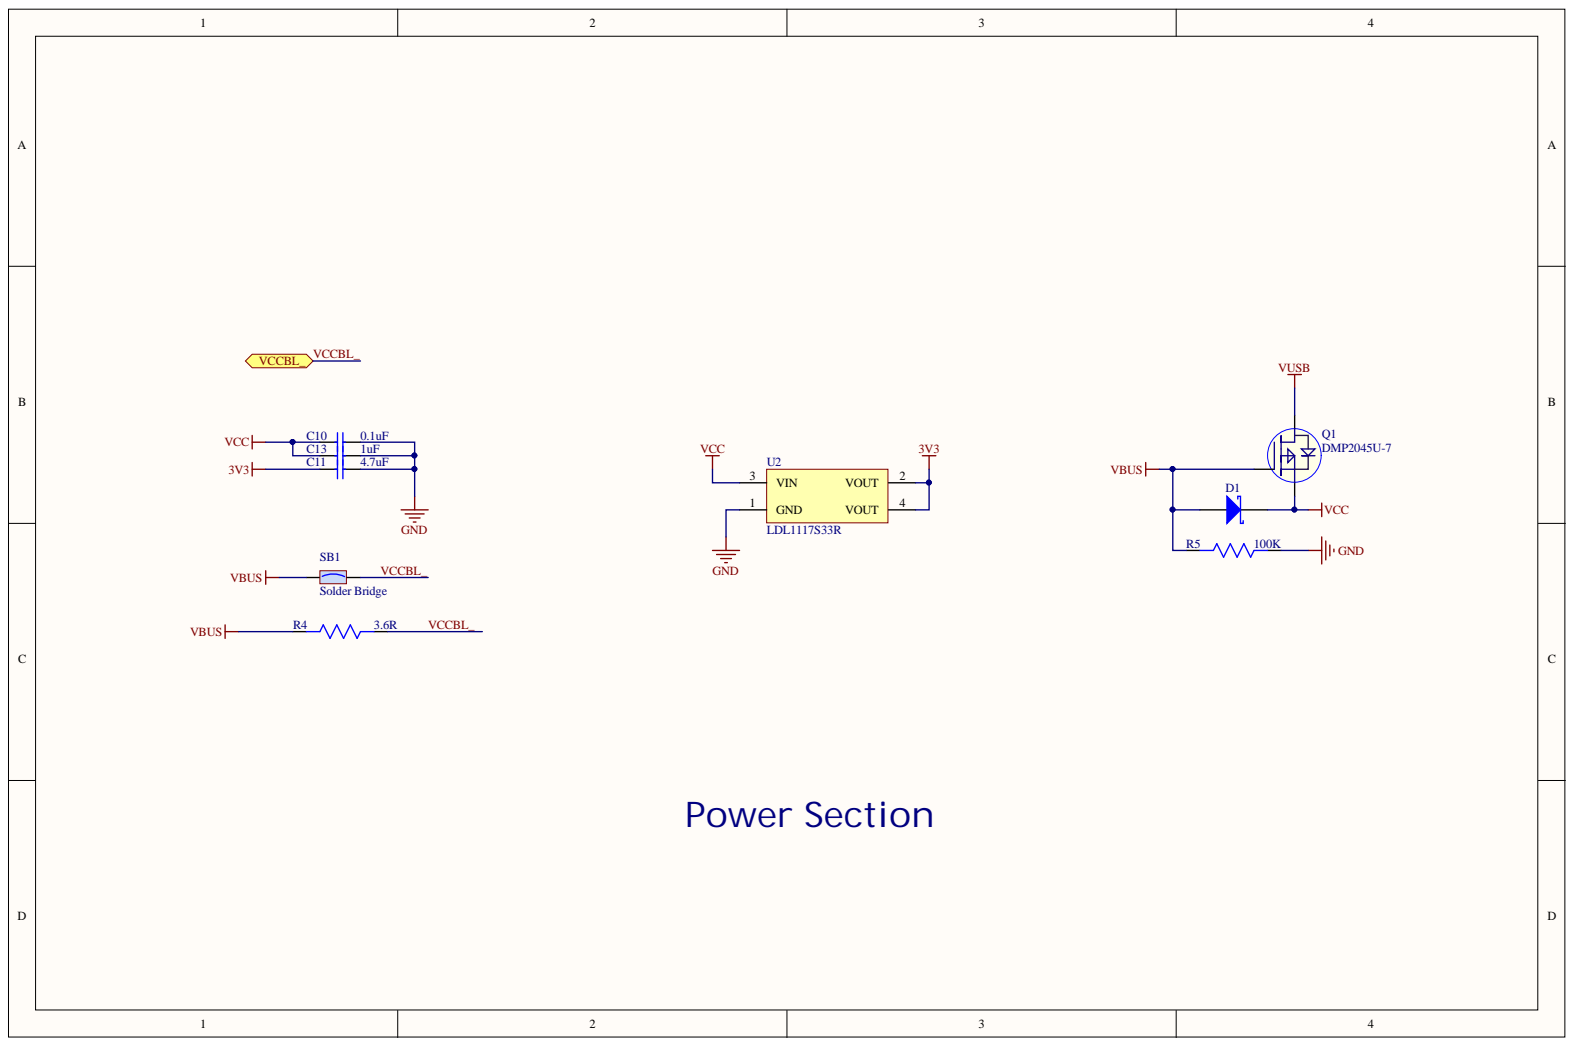
[picture p25: page 2]

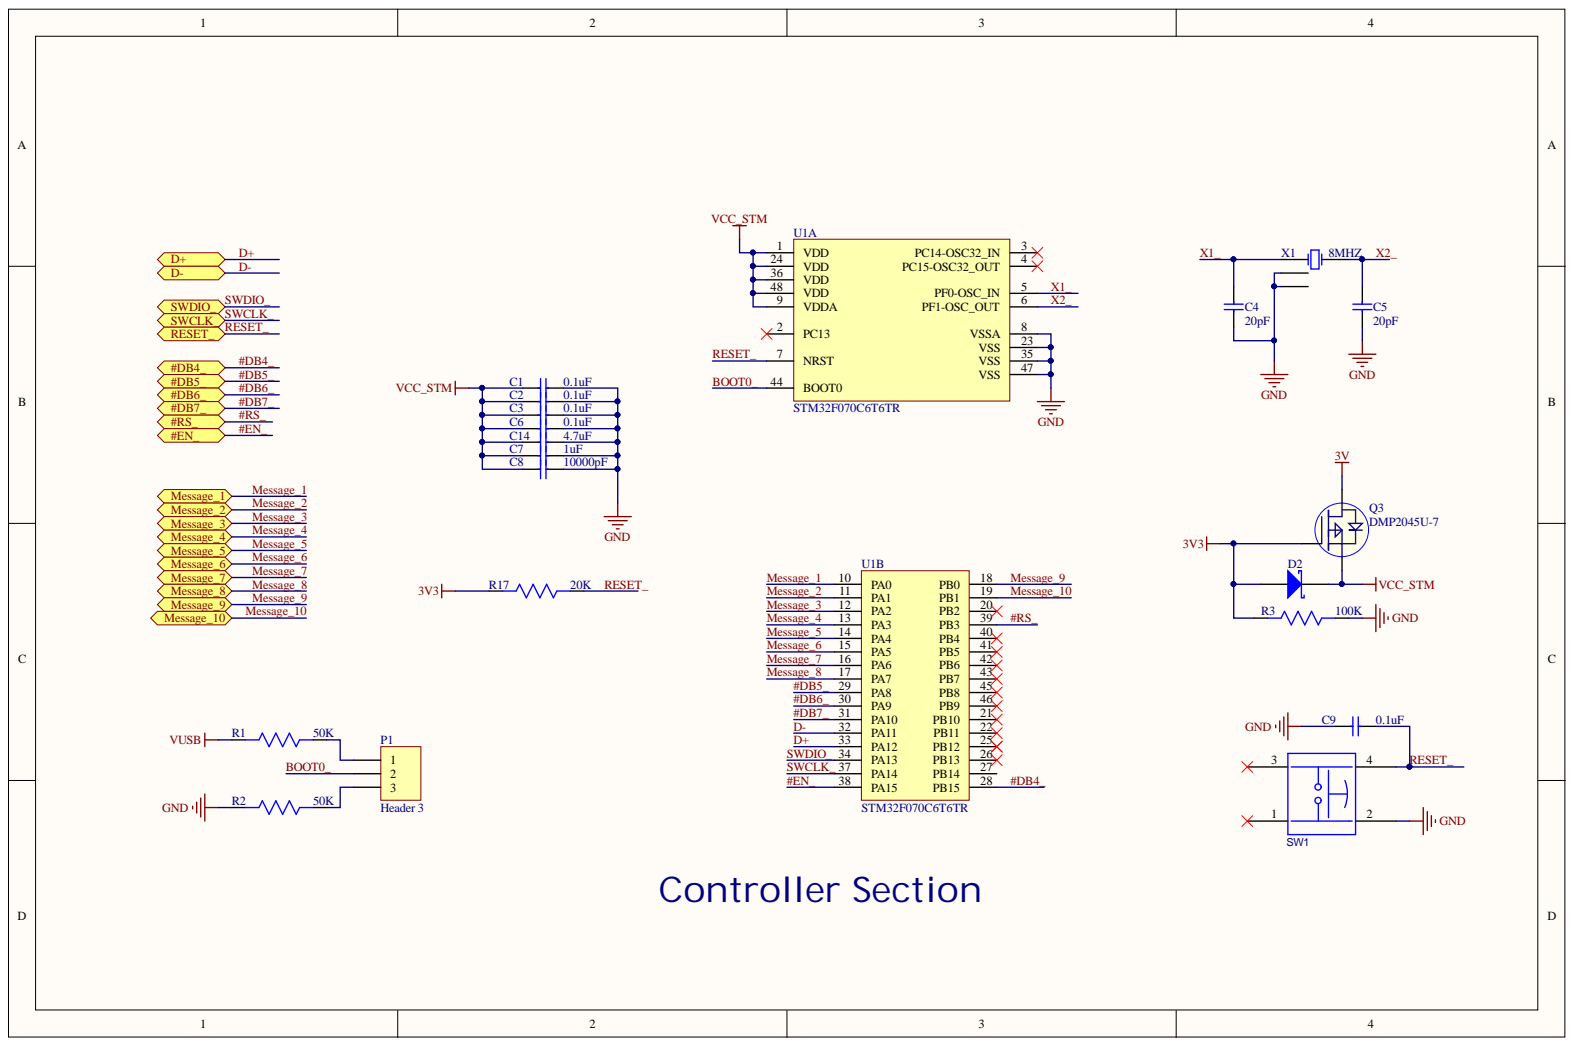
[picture p26: page 3]

C 2 | 0.1uF
C 3 | 0.1uF
C 6 | 0.1uF
C14 | | 4.7uF
C 7 | | 1uF

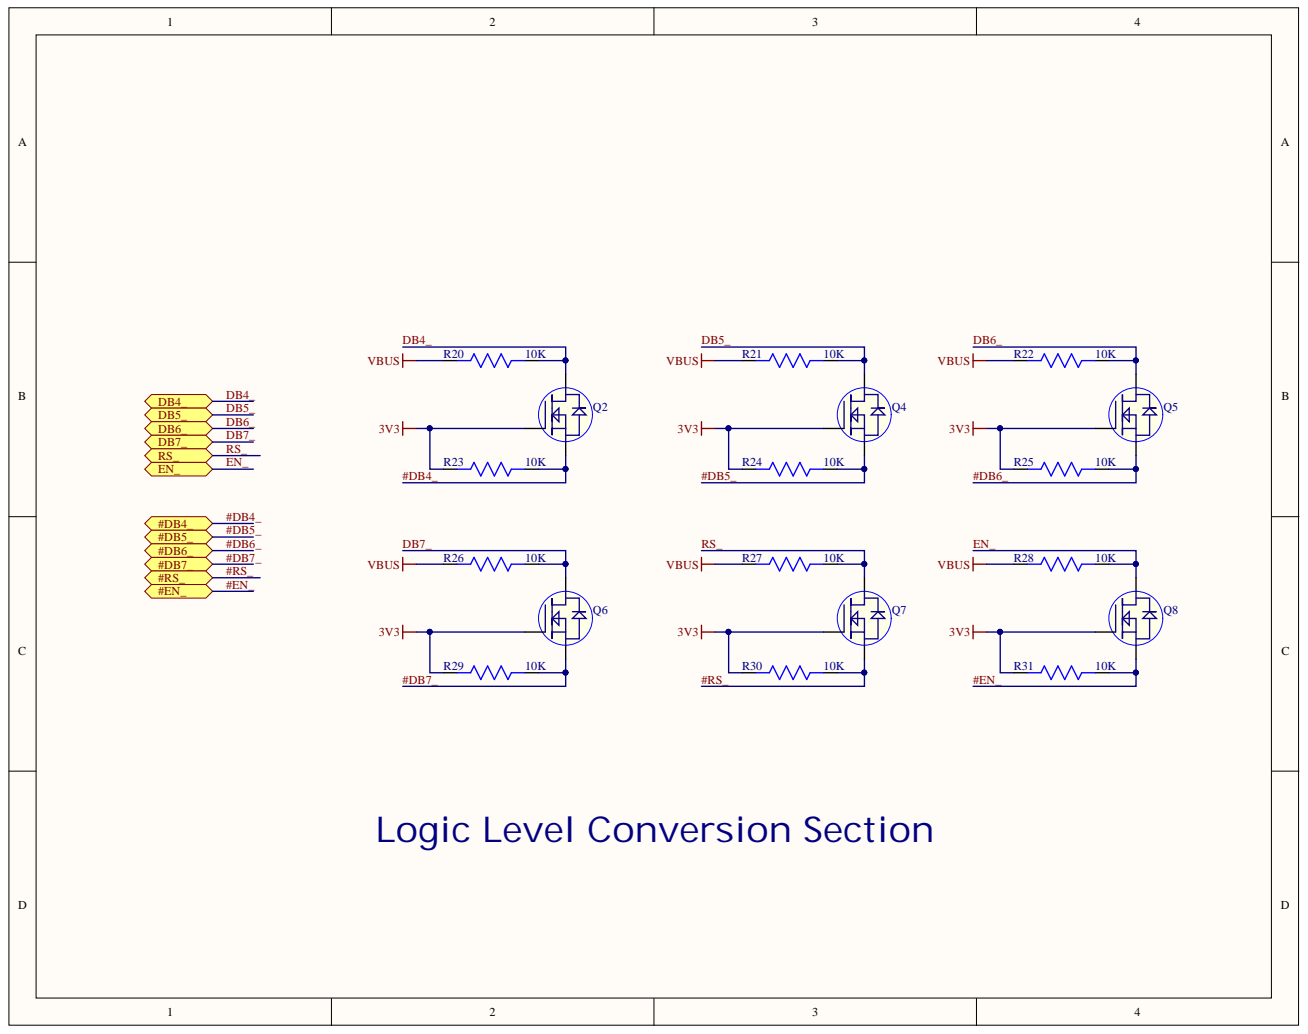
[picture p27: page 4]

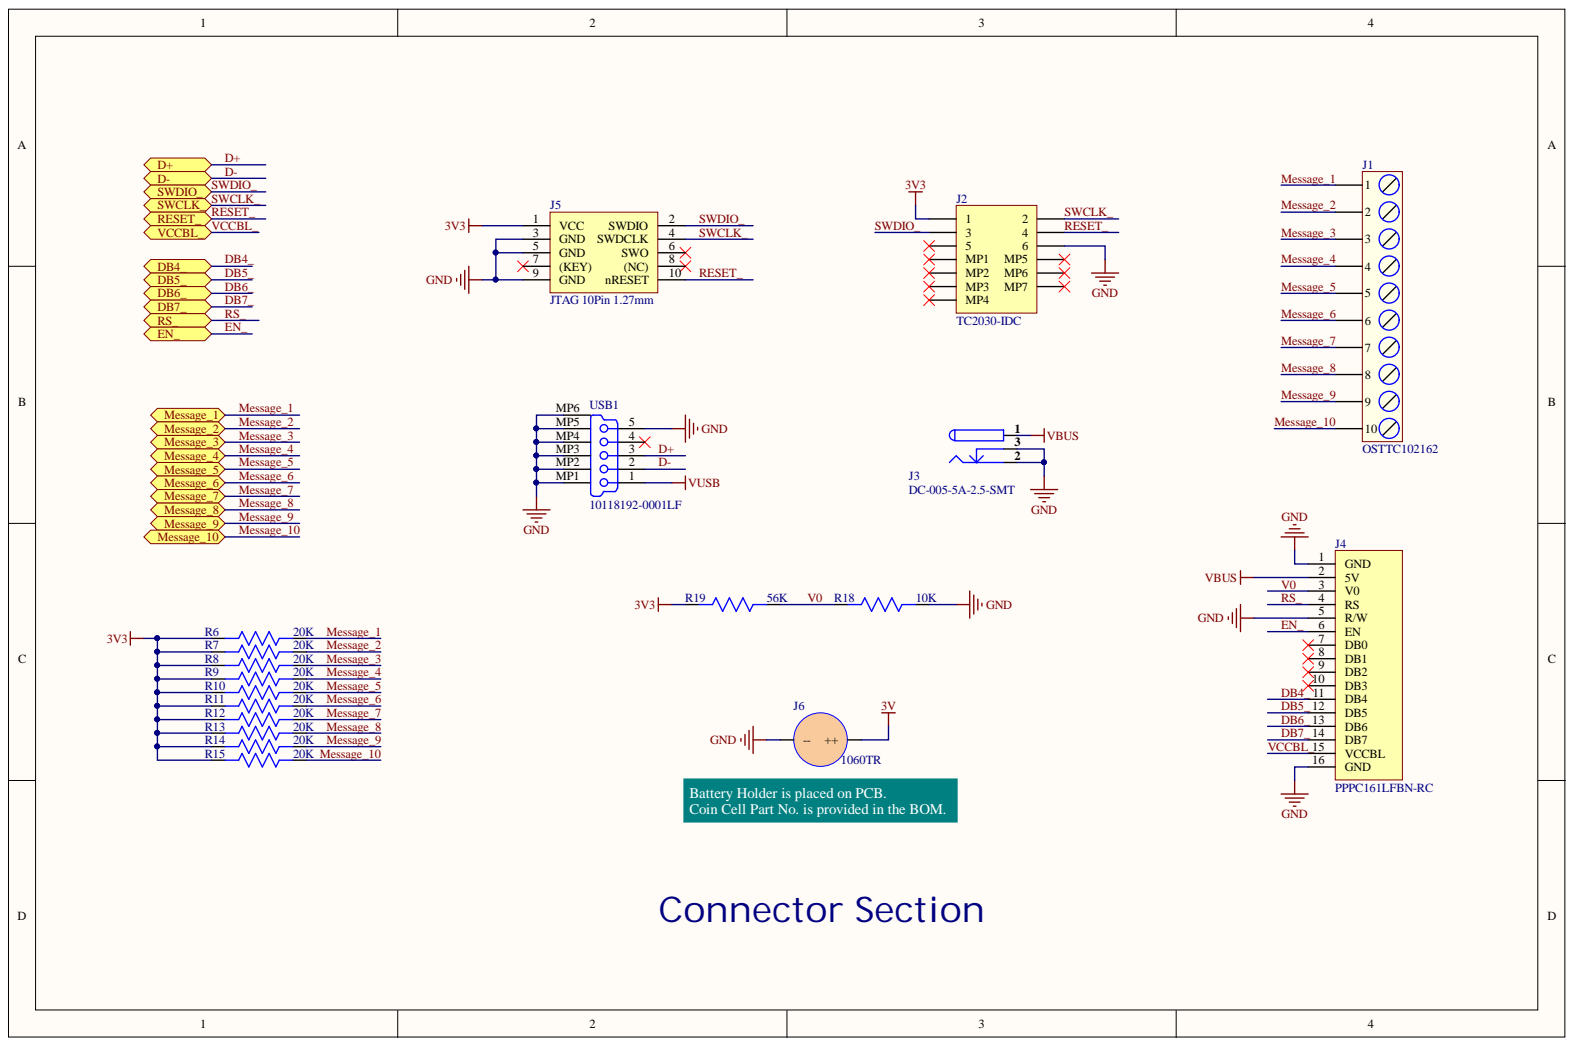
[picture p28: page 5]

5 | 6 RESET_
