eSpark-Backup/johnwollam-lcdproject/Deliverables/Schematics/Assembly_Drawing.pdf

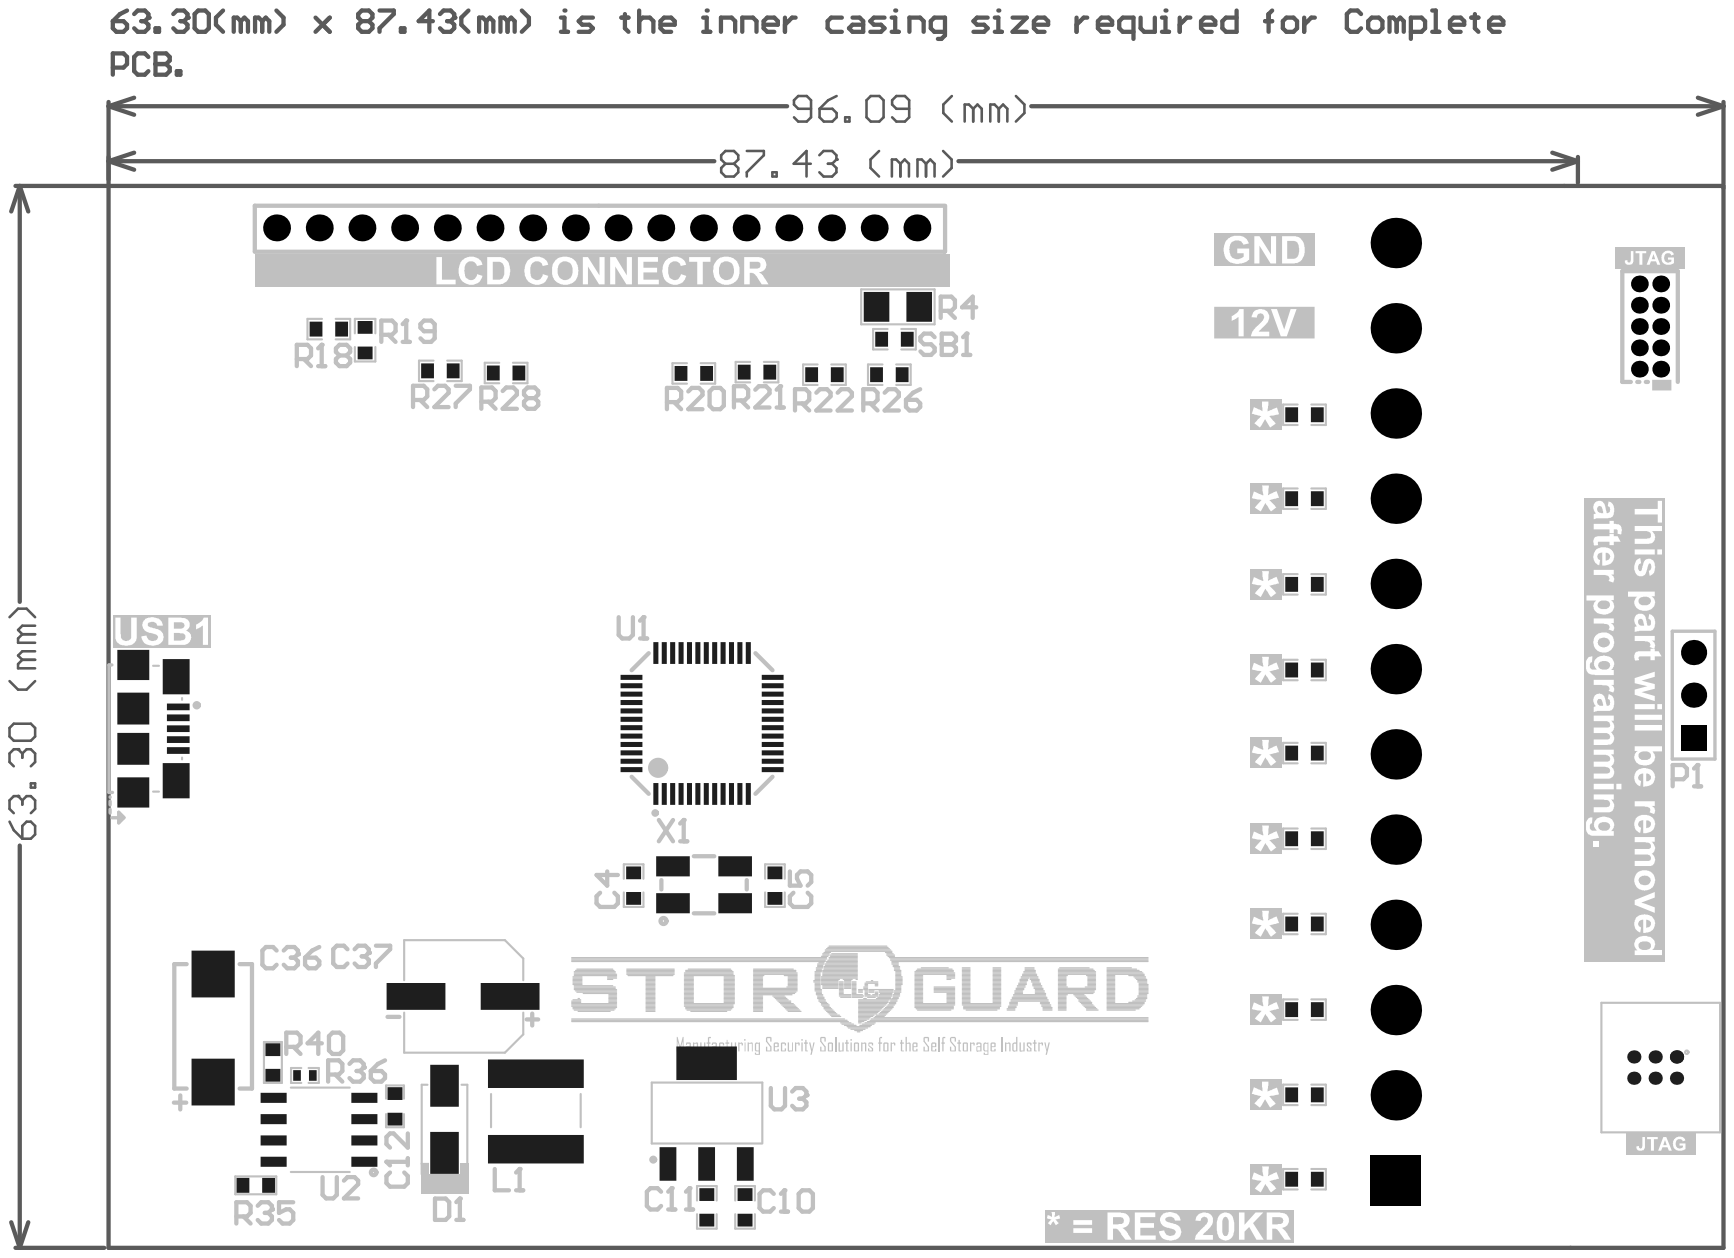
[picture p33: page 1]

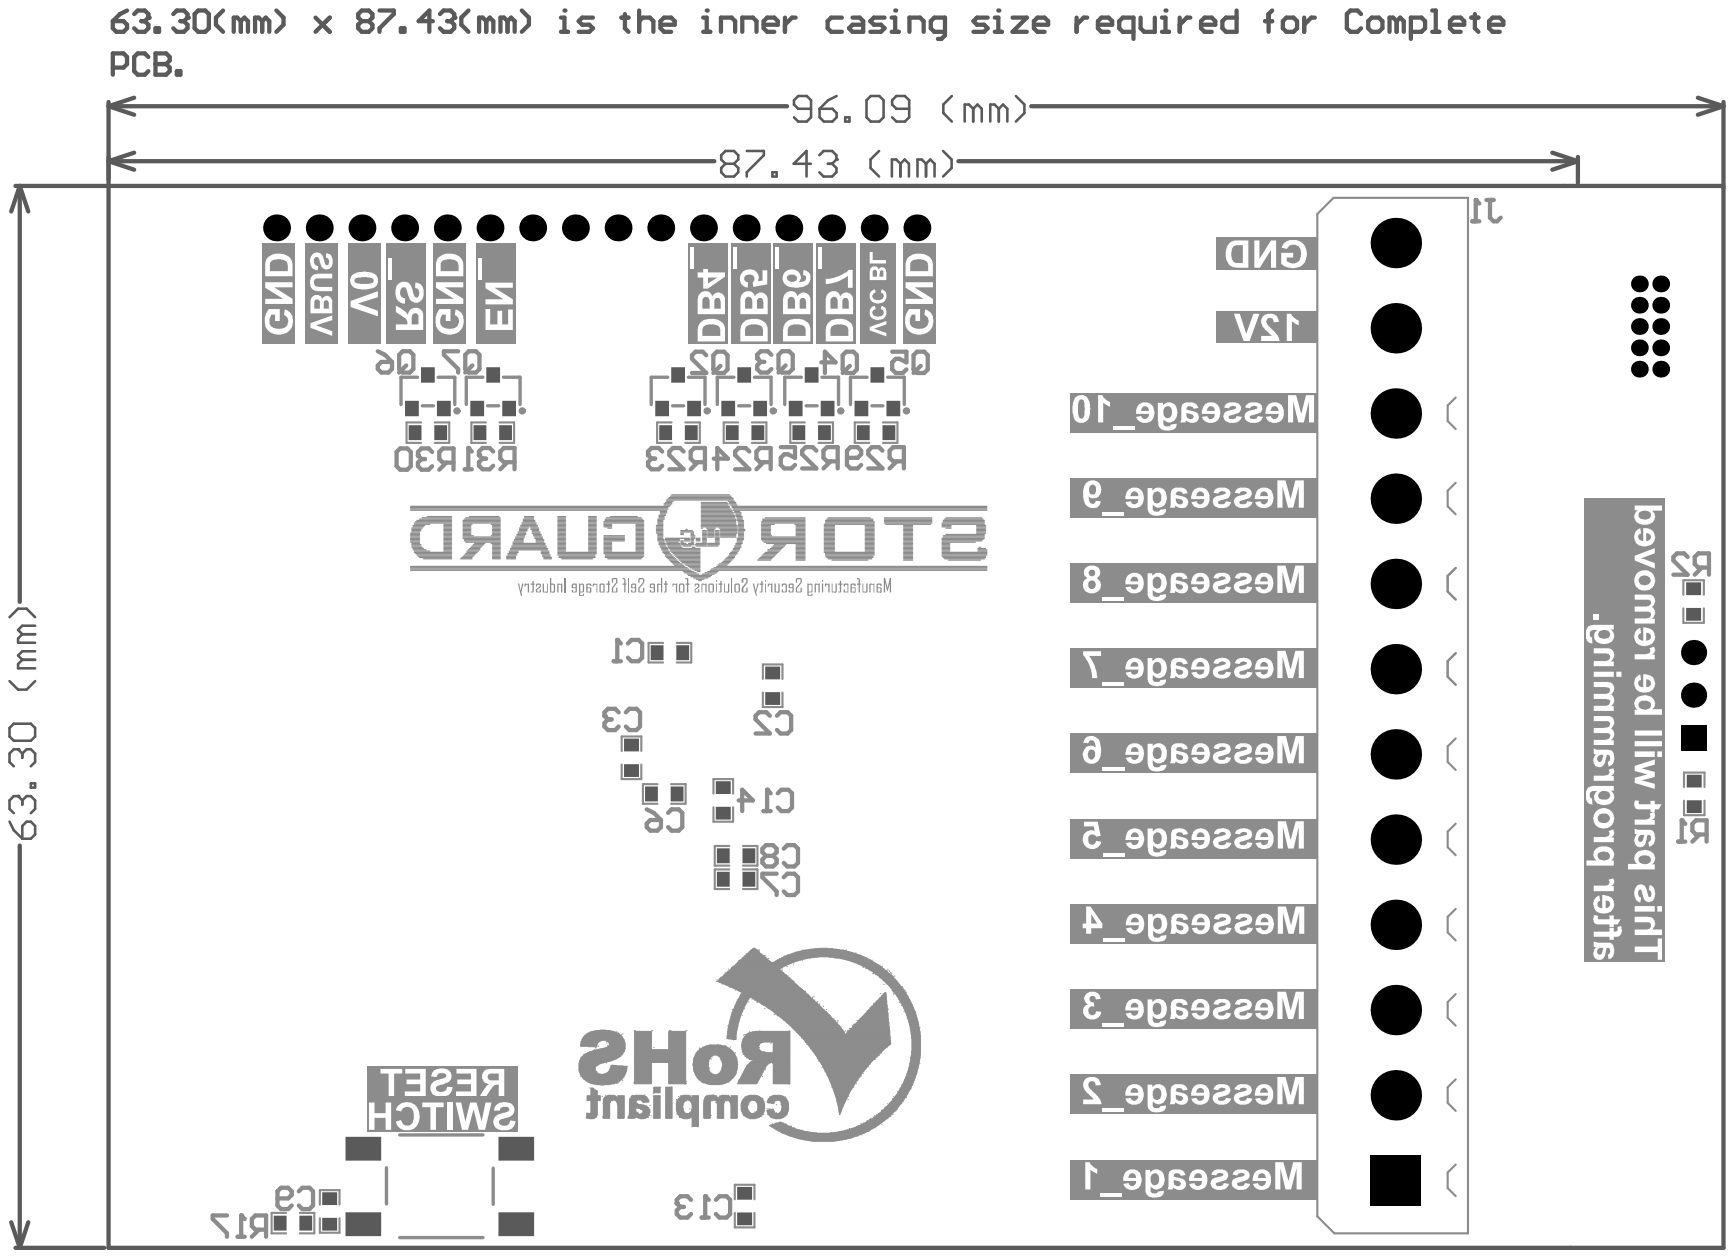
[picture p34: page 2]
