eSpark-Backup/johnwollam-lcdproject/Design files/_Design_Files_New/Assembly Drawings.pdf

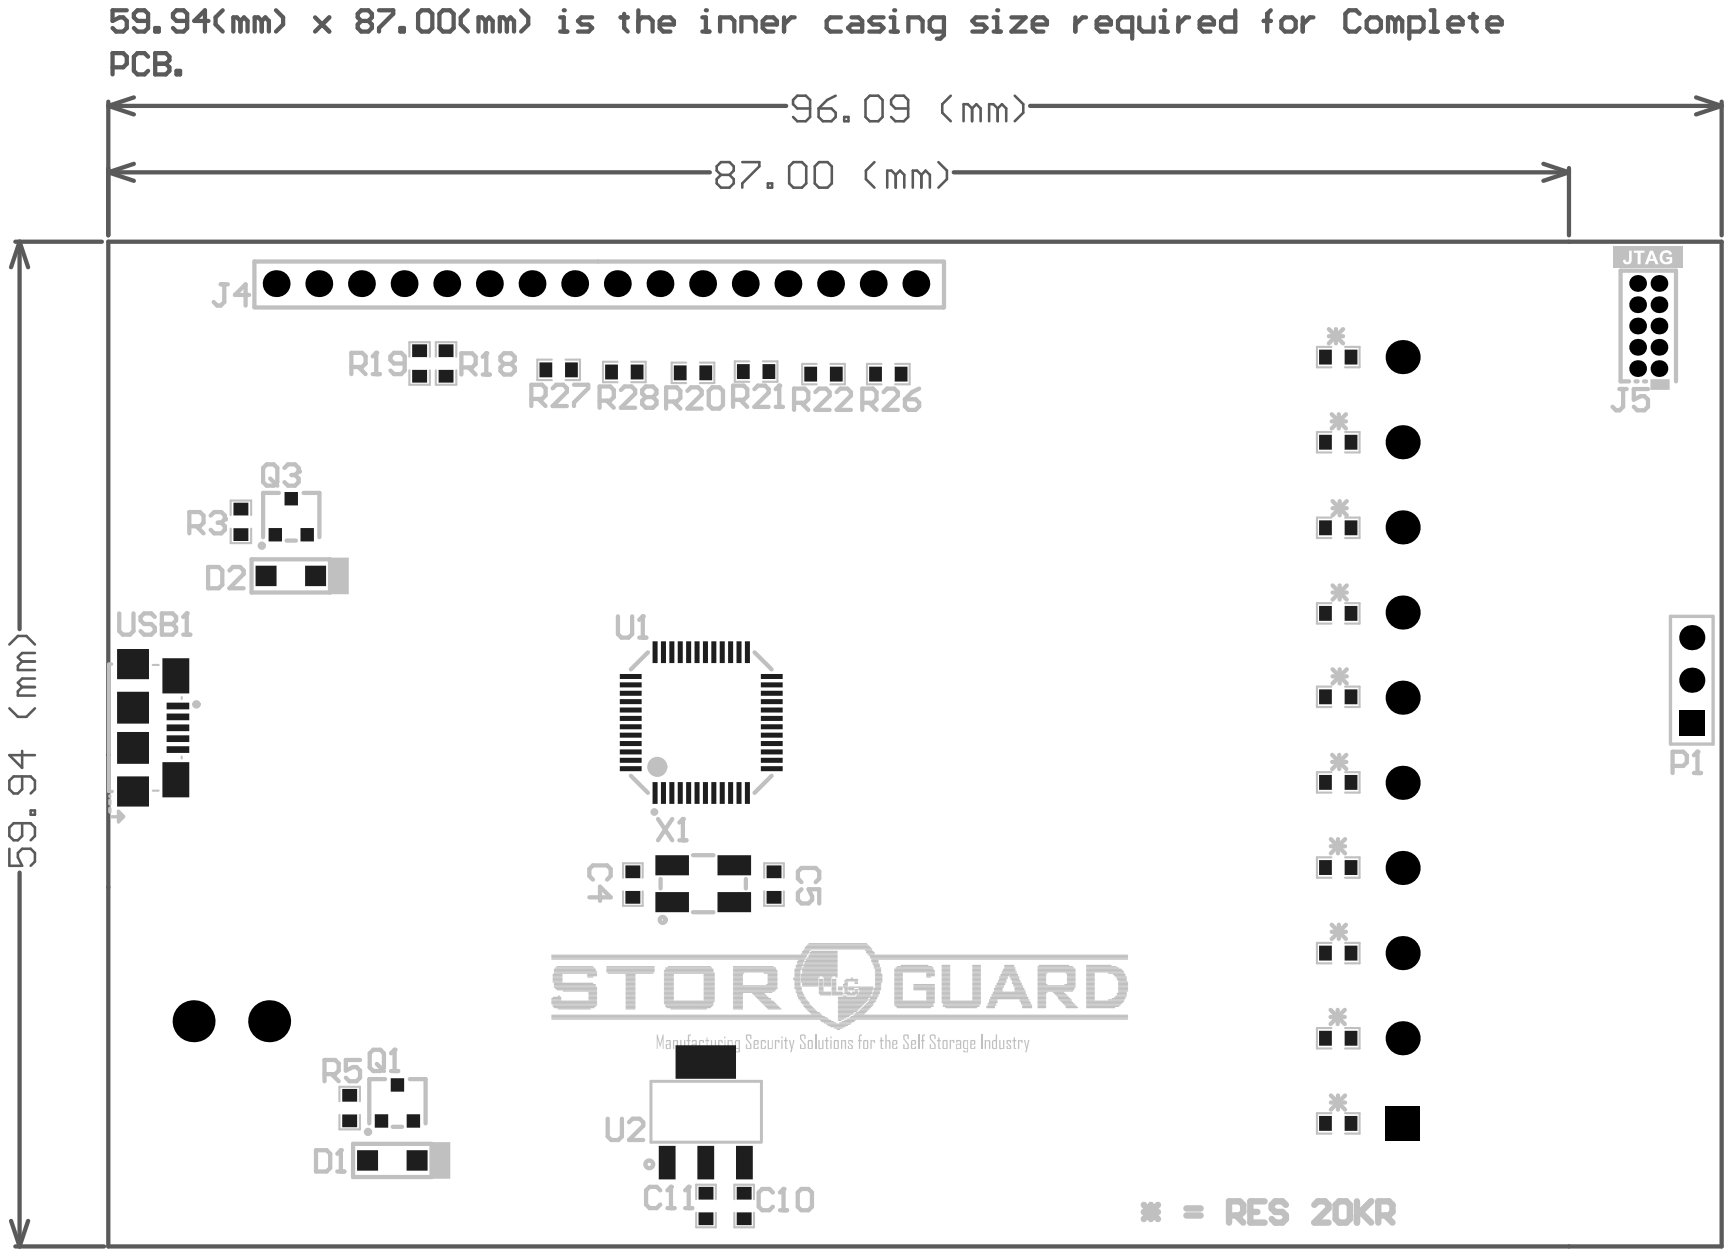
[picture p35: page 1]

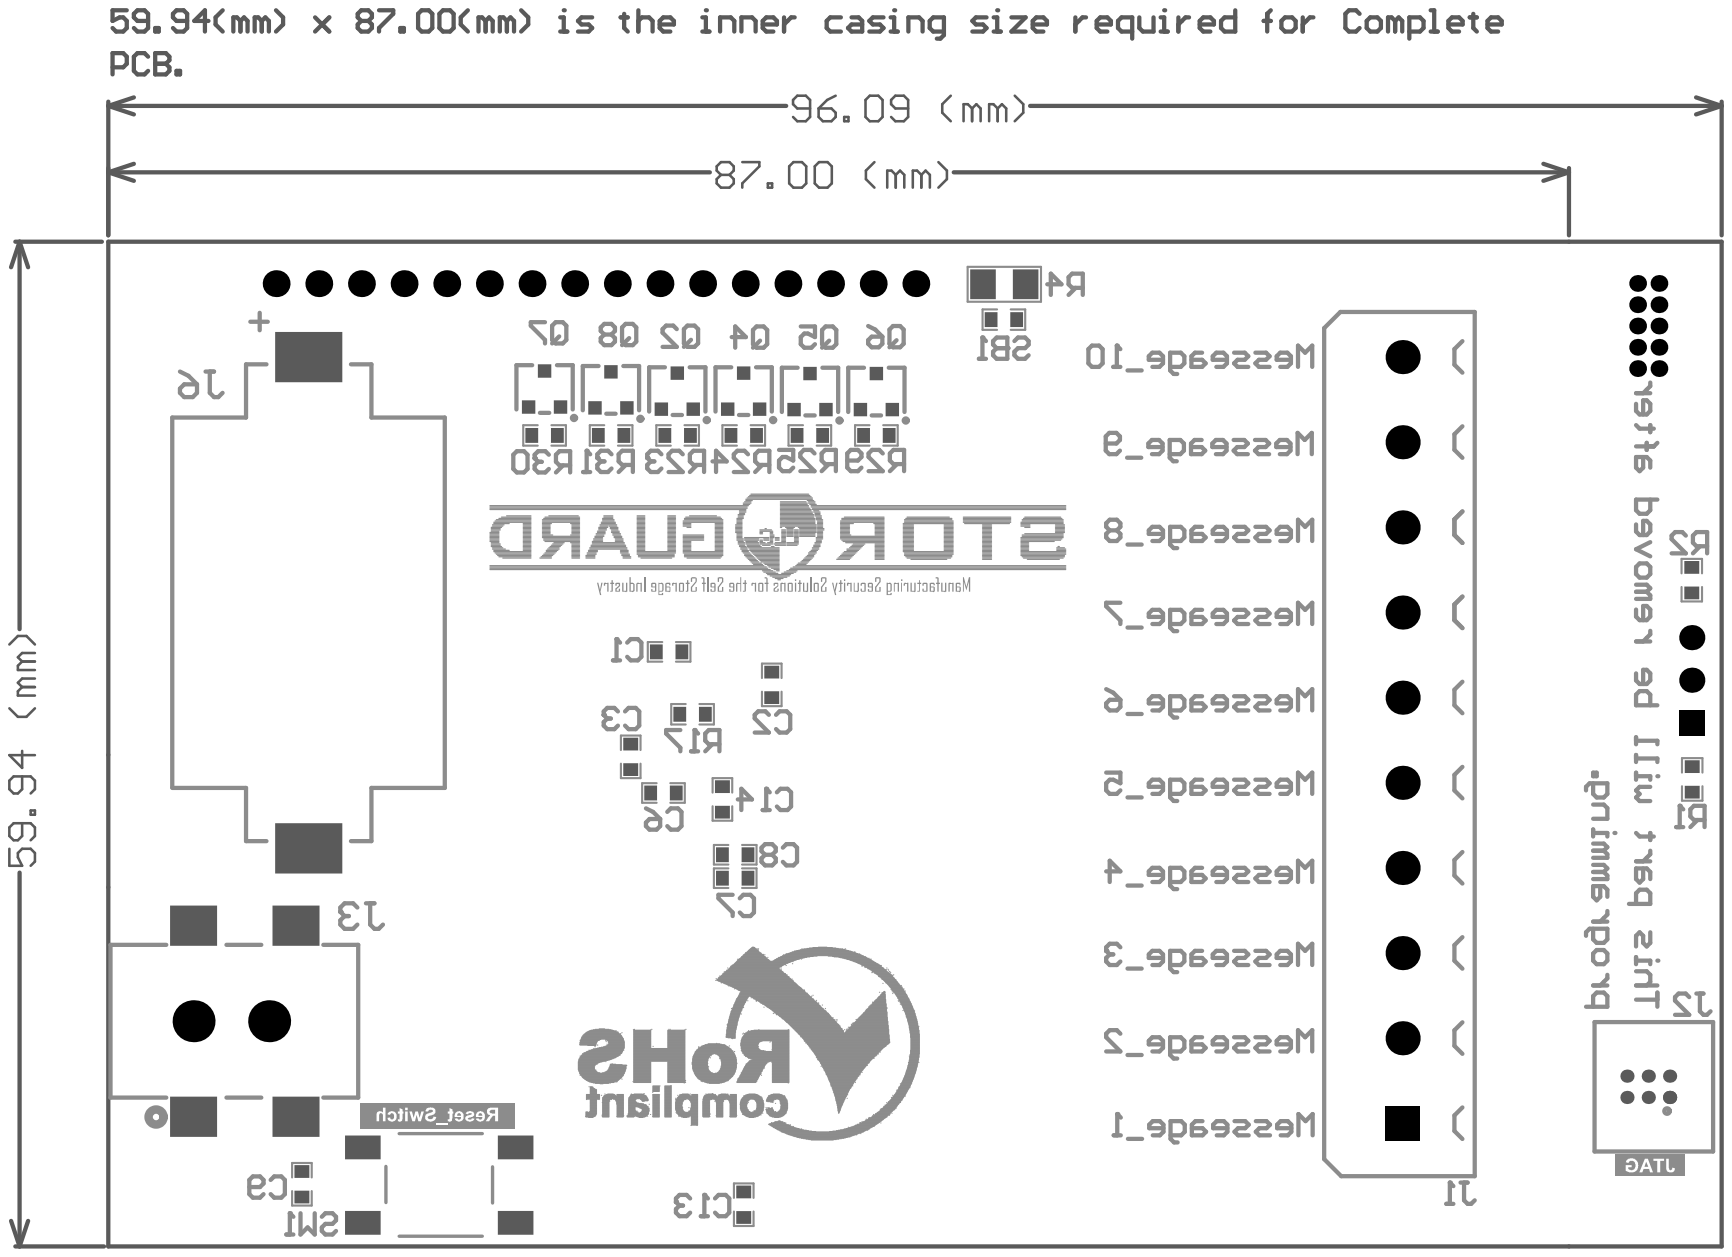
[picture p36: page 2]
