eSpark-Backup/johnwollam-lcdproject/(list of files, drawings)

Other design files:
Design files/_Design_Files_New/Connector_Section.SchDoc
Design files/_Design_Files_New/Controller_Section.SchDoc
Design files/_Design_Files_New/John Wollam.PrjPCB
Design files/_Design_Files_New/John_Wollam.PcbDoc
Design files/_Design_Files_New/Logiclevel_Converter_Section.SchDoc
Design files/_Design_Files_New/Power_Section.SchDoc
Design files/_Design_Files_New/Top_Sheet.SchDoc
Design files/Connector_Section.SchDoc
Design files/Controller_Section.SchDoc
Design files/John Wollam.PrjPCB
Design files/John_Wollam.PcbDoc
Design files/John_Wollam_Old.PcbDoc
Design files/John_Wollam_V2.0.PcbDoc
Design files/Logiclevel_Converter_Section.SchDoc
Design files/PCB1.PcbDoc
Design files/Power_Section.SchDoc
Design files/Top_Sheet.SchDoc
