eSpark-Backup/johnwollam-lcdproject/(commit log)

2022-05-30 Schematic updated as per library review and formatted #22 #19
2022-05-31 #19 Schematic formatting completed.
2022-05-31 Schematic updated acc to #27 #21 #26, and work on #23
2022-06-01 Replaced 5V LDO with Switching Regulator #28 library parts added #29 and PCB updated #23 acc to #28 #29
2022-06-01 Minor changes in PCB during review. See #31 for details.
2022-06-08 Mounting holes aligned w.r.t LCD #36
2022-10-26 Schematic changes #44
2022-10-27 Schematic changes complete #44
2022-10-28 #46 Espark BOM completed
2022-10-28 BOM reviewed #47
2022-11-28 #52 LCSC And PCBWay BOM added.
2022-11-28 S.no correction in LCSC BOM
2022-12-19 added per board quantity in PCBWay BOM
